squaregolab/moveoperpi/USER MANUAL/schema moveo.jpg

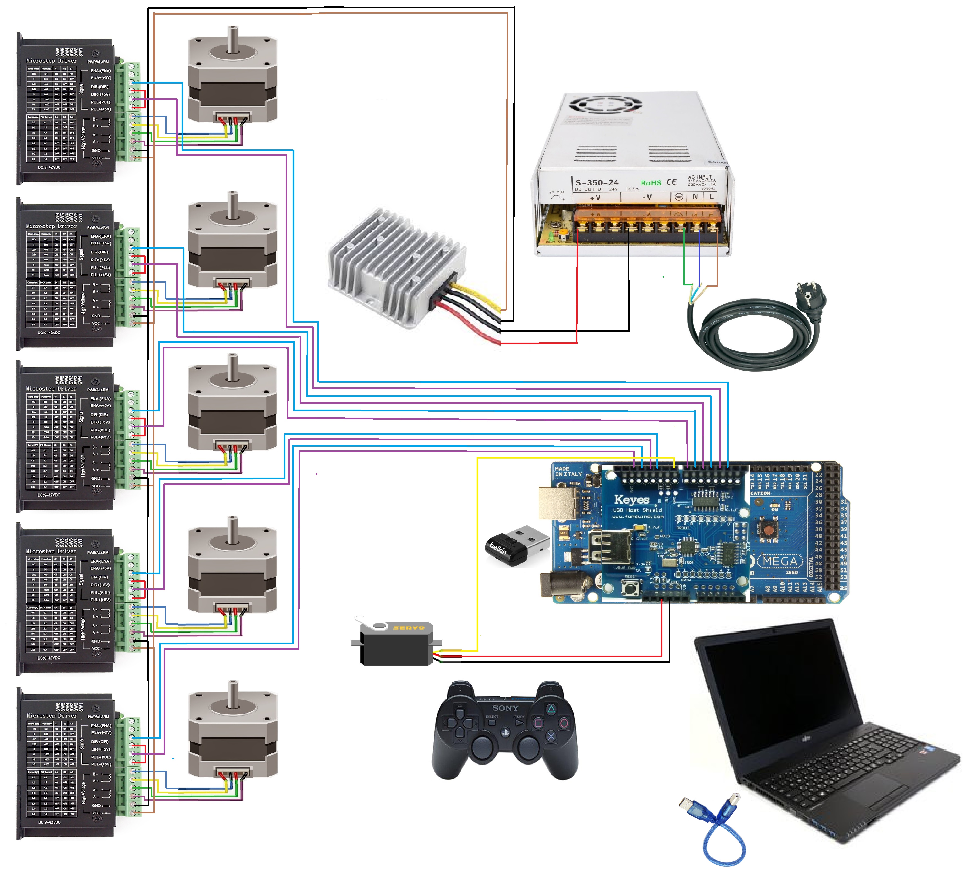
USER MANUAL/schema moveo.jpg
