squaregolab/moveoperpi/PHOTOS/20180124_114116.jpg

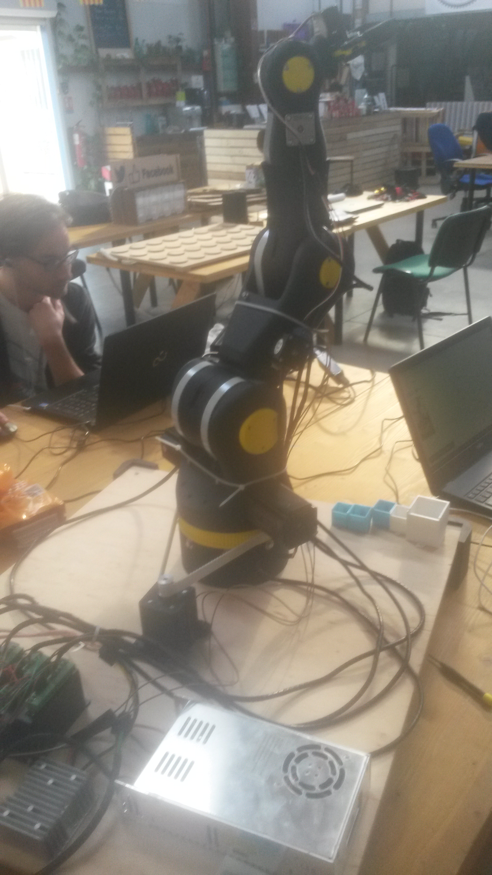
PHOTOS/20180124_114116.jpg
