squaregolab/moveoperpi/PHOTOS/20180117_152939.jpg

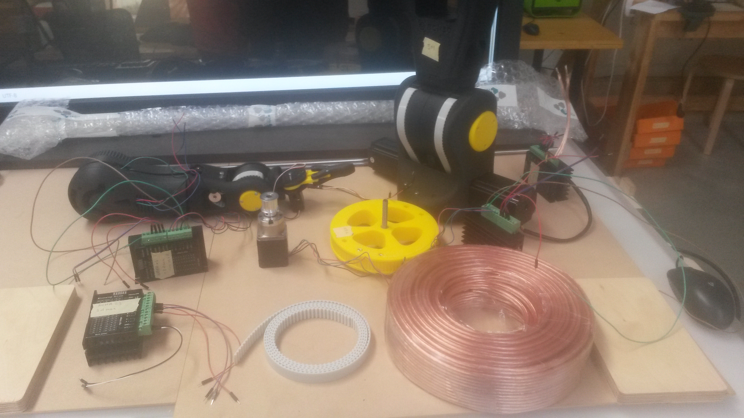
PHOTOS/20180117_152939.jpg
