squaregolab/moveoperpi/PHOTOS/20180117_152953.jpg

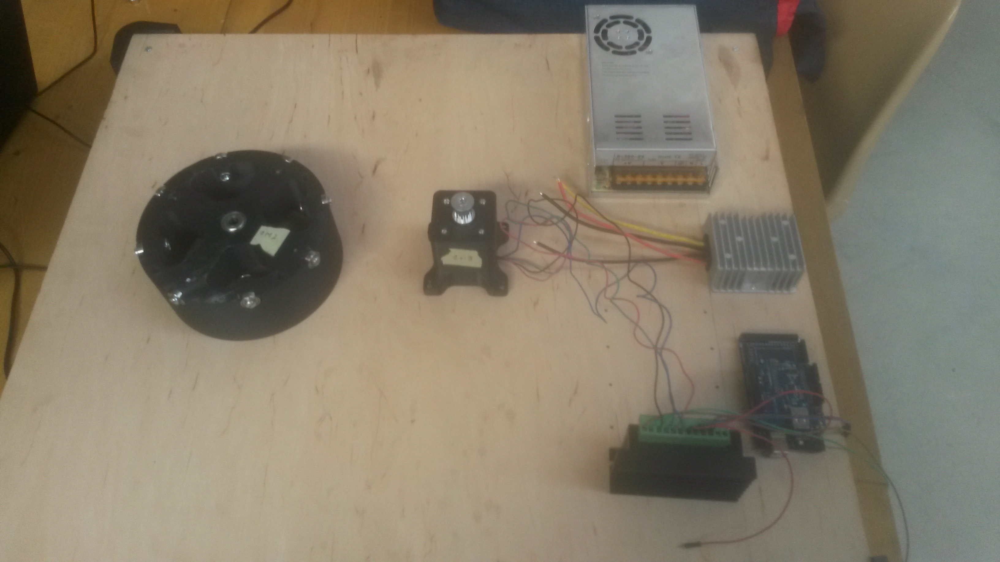
PHOTOS/20180117_152953.jpg
