squaregolab/moveoperpi/PHOTOS/20180117_153352.jpg

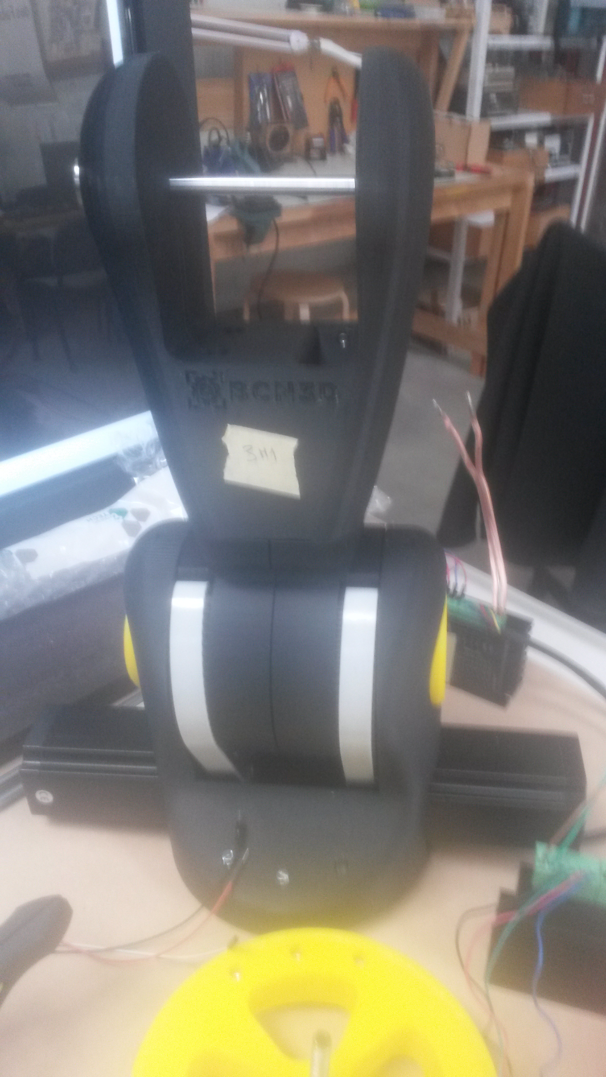
PHOTOS/20180117_153352.jpg
