squaregolab/moveoperpi/PHOTOS/20180117_153404.jpg

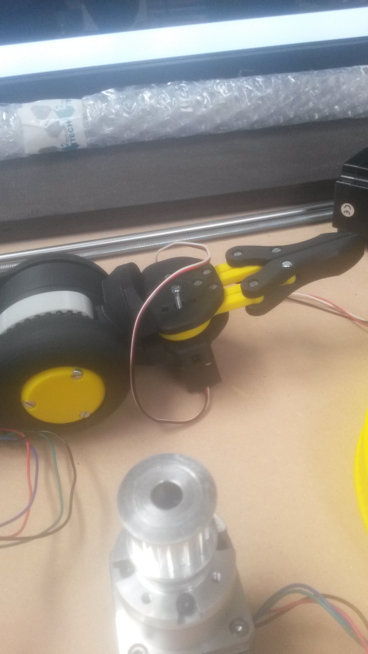
PHOTOS/20180117_153404.jpg
