squaregolab/moveoperpi/PHOTOS/20180117_153409.jpg

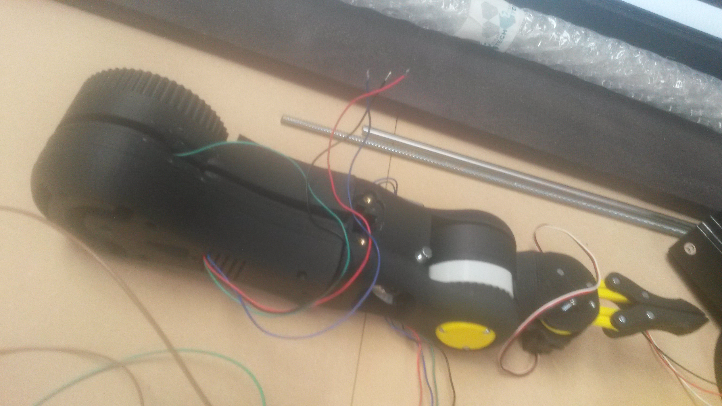
PHOTOS/20180117_153409.jpg
