squaregolab/moveoperpi/PHOTOS/20180118_113516.jpg

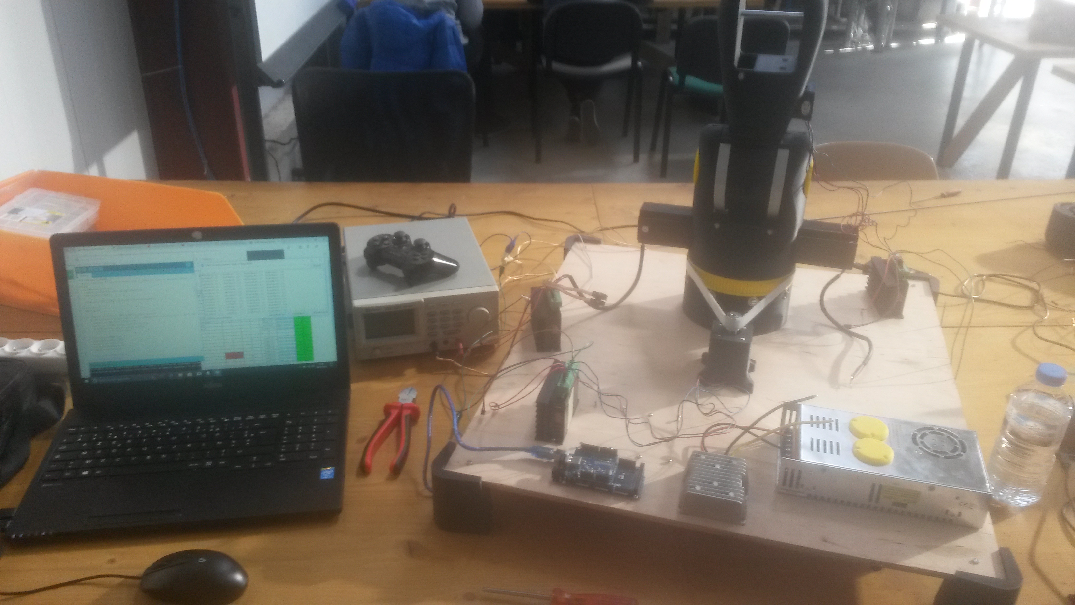
PHOTOS/20180118_113516.jpg
