squaregolab/moveoperpi/PHOTOS/20180118_113524.jpg

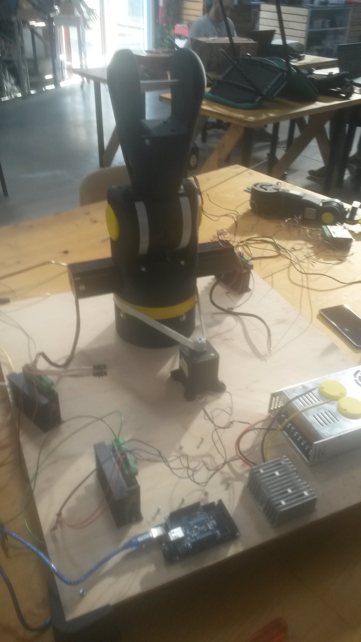
PHOTOS/20180118_113524.jpg
