squaregolab/moveoperpi/PHOTOS/20180122_131329.jpg

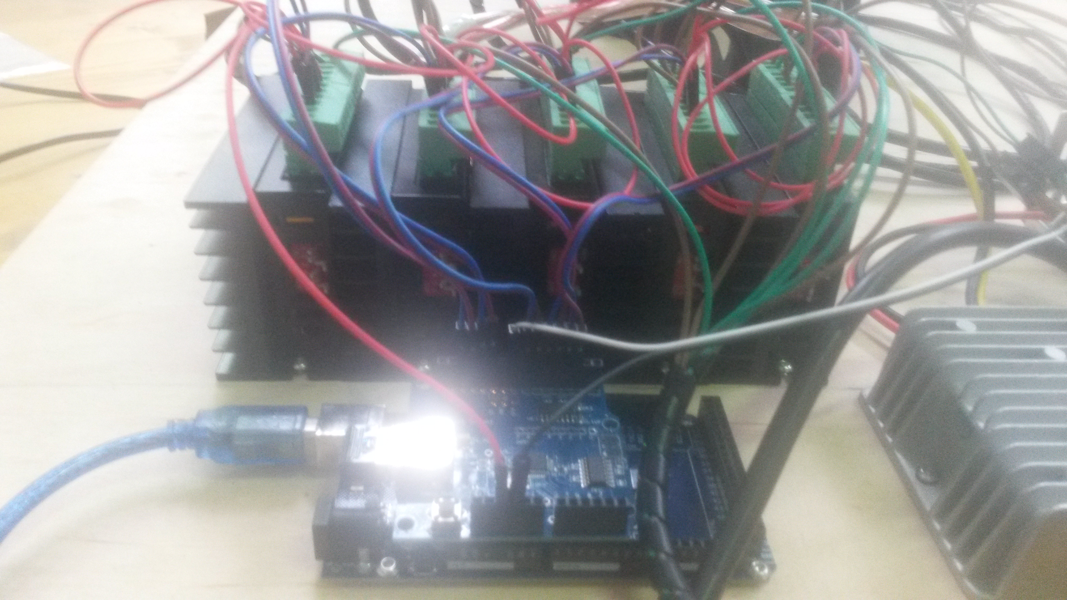
PHOTOS/20180122_131329.jpg
