squaregolab/moveoperpi/PHOTOS/20180122_131335.jpg

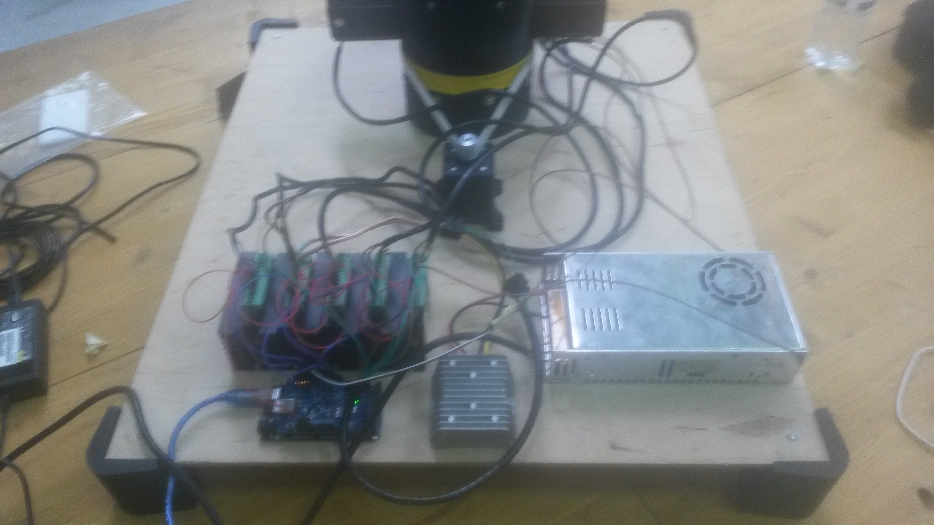
PHOTOS/20180122_131335.jpg
