squaregolab/moveoperpi/PHOTOS/20180124_090855.jpg

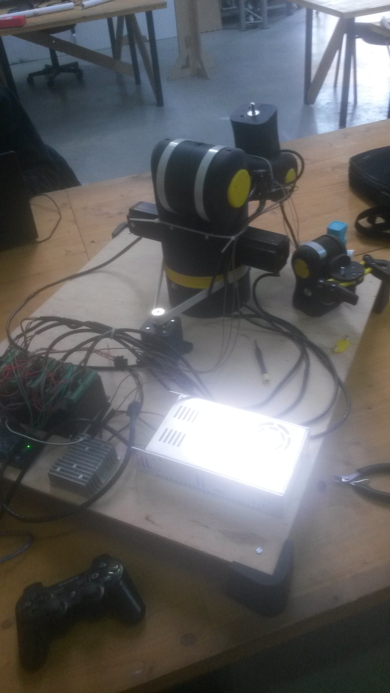
PHOTOS/20180124_090855.jpg
