squaregolab/moveoperpi/PHOTOS/20180124_114030.jpg

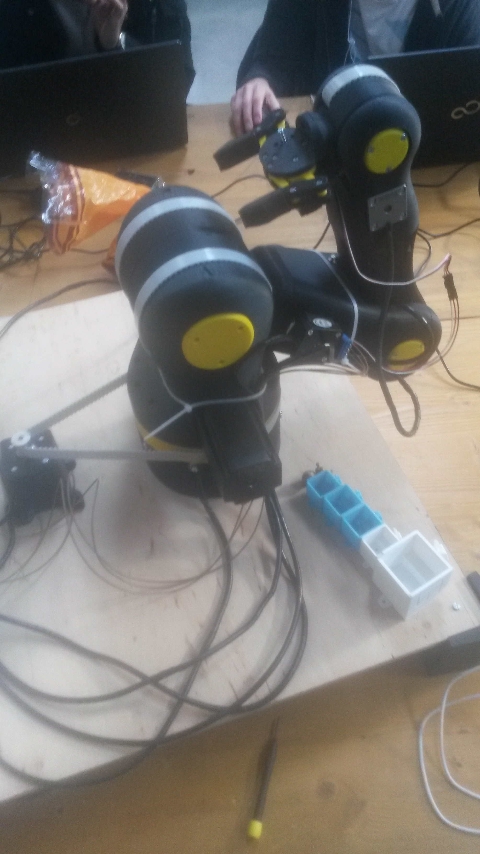
PHOTOS/20180124_114030.jpg
