squaregolab/moveoperpi/PHOTOS/20180124_114136.jpg

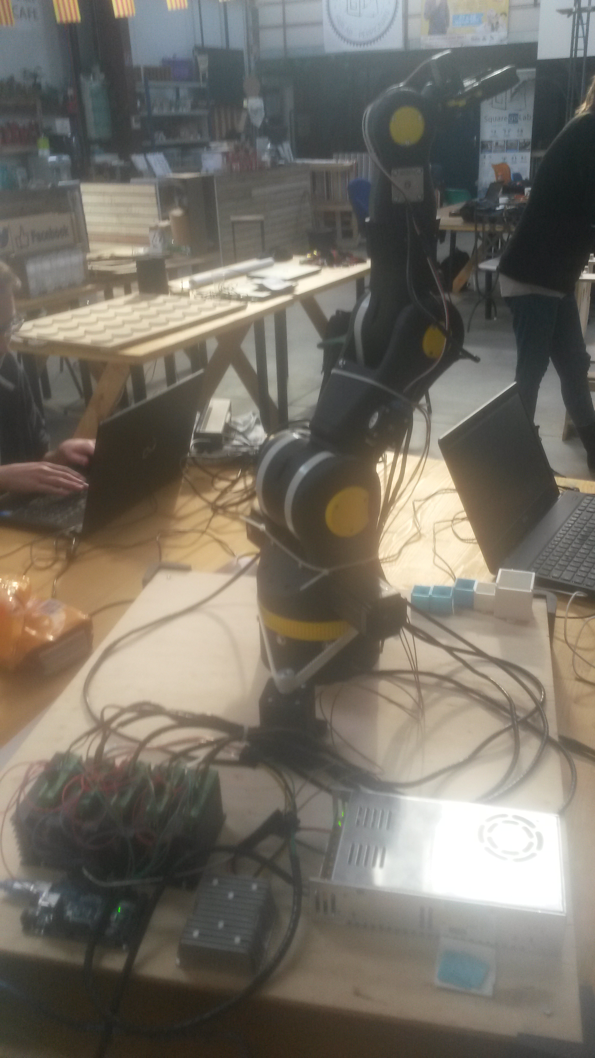
PHOTOS/20180124_114136.jpg
