squaregolab/moveoperpi/CAD files/Driver.SLDASM

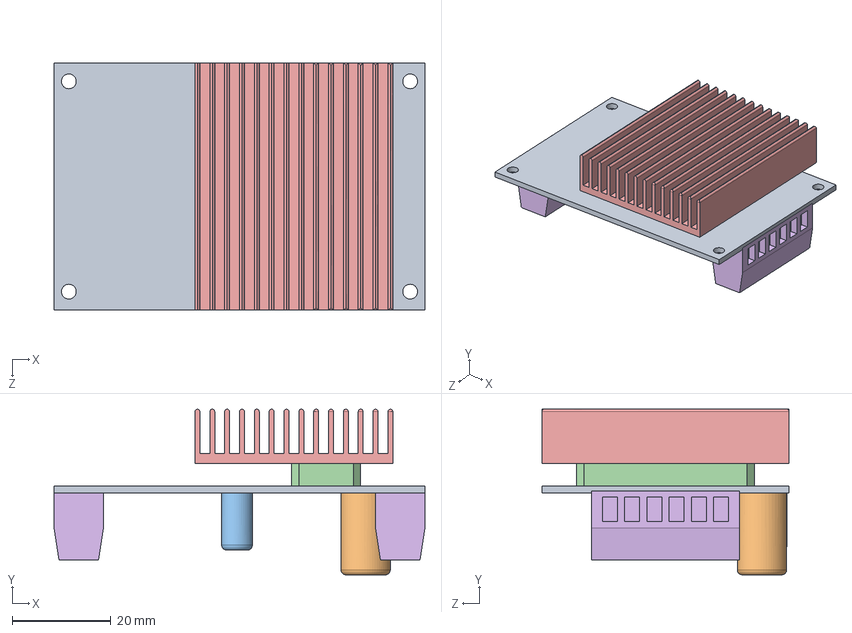
[picture p17: CAD file, 2018-02-10]
CAD files/Driver.SLDASM
75.0 x 33.5 x 50.0 mm
PCB TB6560
Capacitor 1
Capacitor 2
Chip
Sink
Terminal x 2
