squaregolab/moveoperpi/CAD files/M1 Tensor D.SLDASM

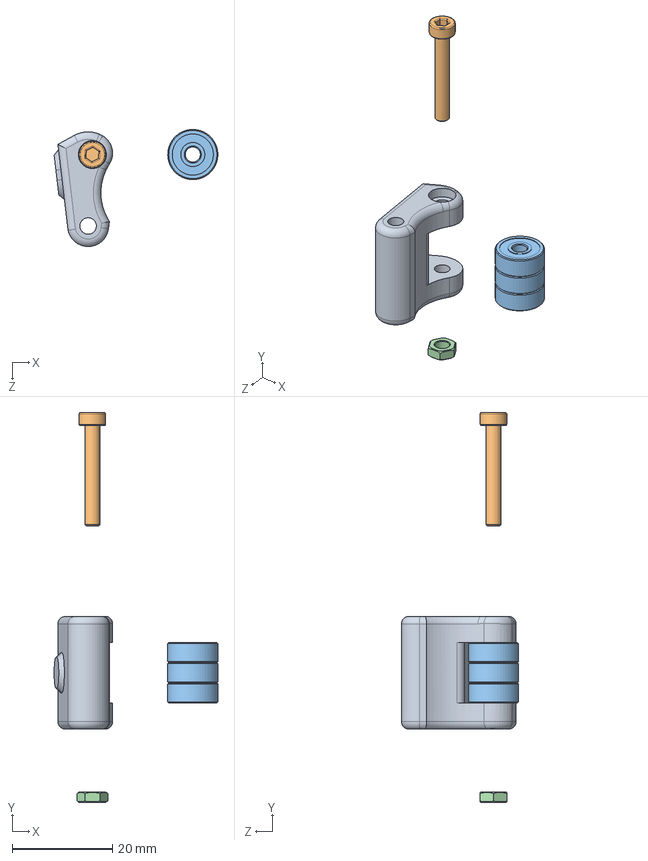
[picture p18: CAD file, 2018-02-10]
CAD files/M1 Tensor D.SLDASM
32.6 x 77.7 x 23.3 mm
T4M1E
M3x20
Bearing 3Bore 10Ext 4Height x 3
M3 Nut
