squaregolab/moveoperpi/CAD files/Rotary Plate.SLDASM

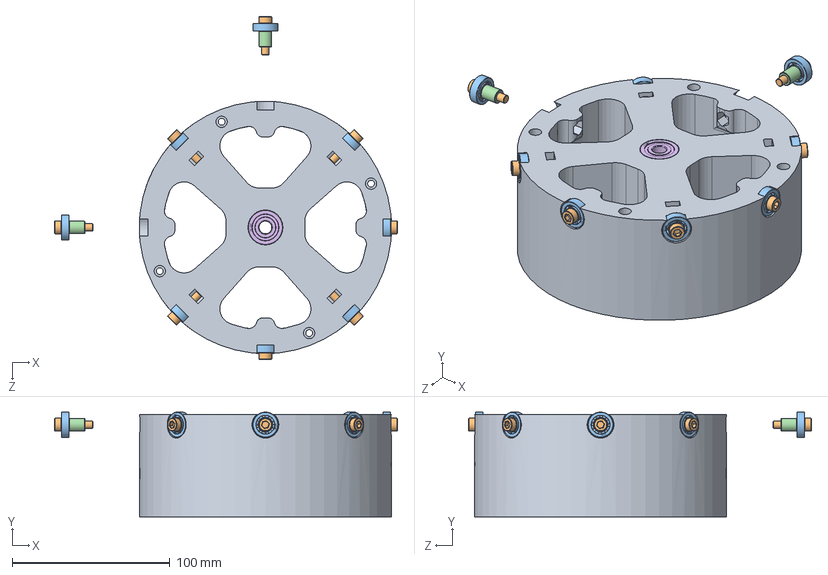
[picture p19: CAD file, 2018-02-10]
CAD files/Rotary Plate.SLDASM
217.5 x 66.5 x 217.5 mm
1M2A
M5x20 x 8
Bearing 5mm x 8
Spacer M5x10 x 8
Spacer M8x20
8mm Bearing x 2
