squaregolab/moveoperpi/CAD files/3M1.SLDASM

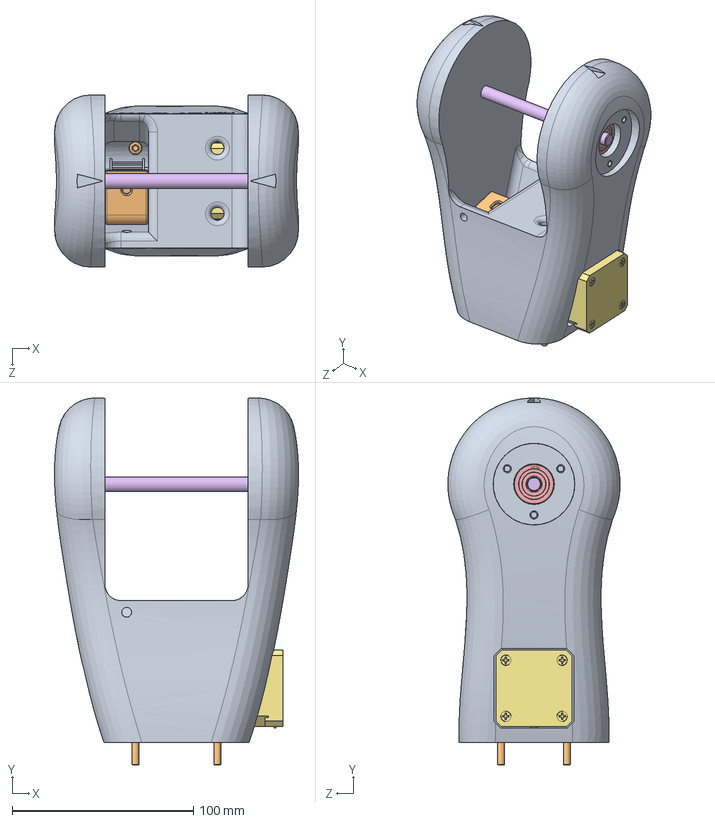
[picture p20: CAD file, 2018-02-10]
CAD files/3M1.SLDASM
134.6 x 202.4 x 95.0 mm
3M1D
T3M1C
M4 Nut
M4x20
Bearing 4Bore 13Ext 5 x 3
M3x40
Nema 17 Reductor
M3x12 x 4
Pulley 8mm IGNIS
M4x16 x 4
M3 Nut
Brass insert M3 x 6
8mm Bearing x 2
Smooth bar 8mm x 121mm
