squaregolab/moveoperpi/CAD files/Base assembly.SLDASM

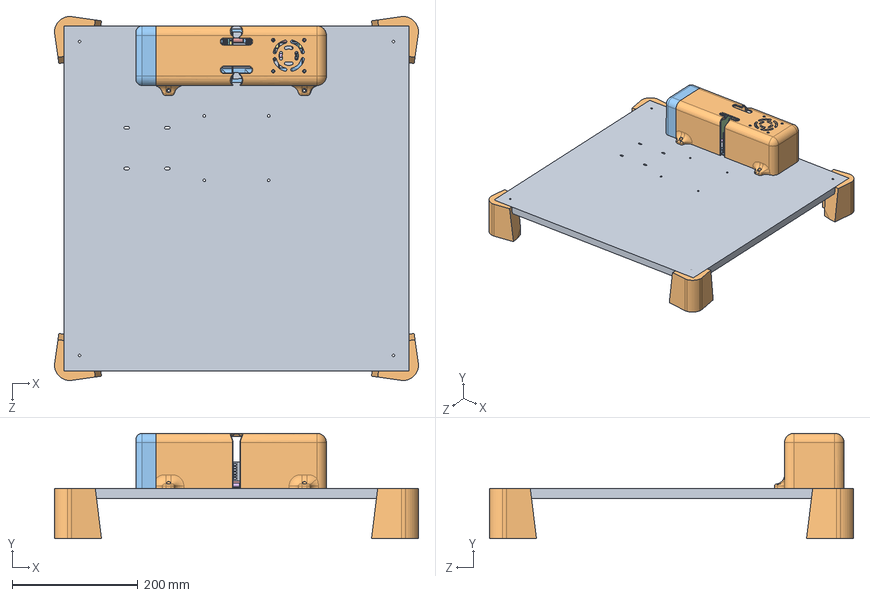
[picture p21: CAD file, 2018-02-10]
CAD files/Base assembly.SLDASM
579.8 x 168.0 x 579.8 mm
Base fusta
Potes base B x 4
Suport Drivers E
PCB TB6560 x 6
Capacitor 1 x 6
Capacitor 2 x 6
Chip x 6
Sink x 6
Terminal x 12
Box C
Fan Module
Fan
