squaregolab/moveoperpi/CAD files/Tensor I.SLDASM

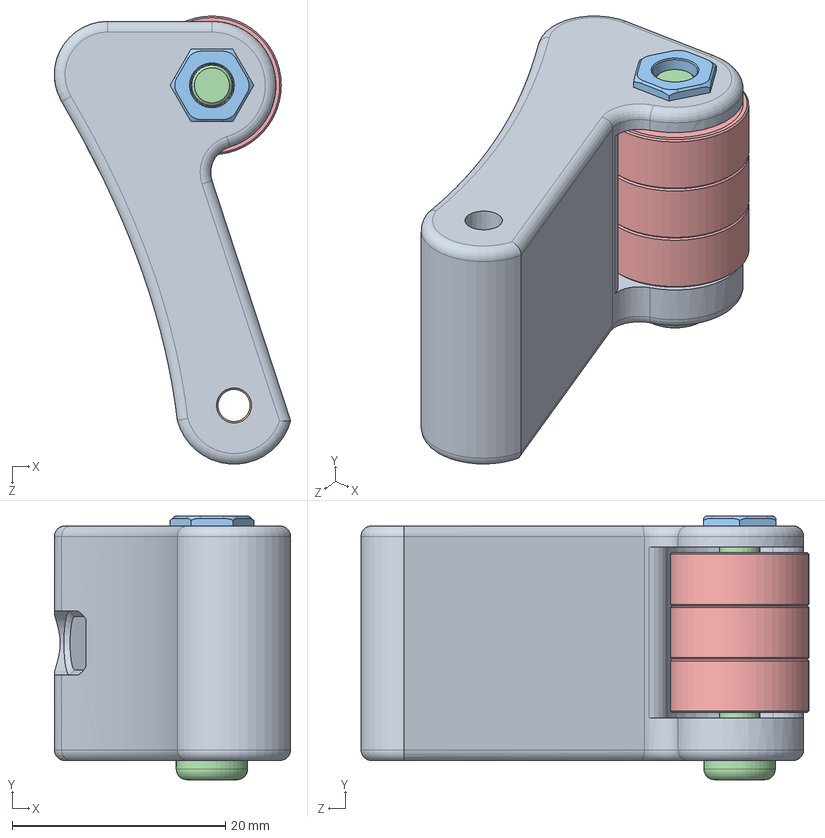
[picture p22: CAD file, 2018-02-10]
CAD files/Tensor I.SLDASM
22.2 x 24.7 x 42.0 mm
T2M1BI
M3 Nut
M4 Nut
M4x20
Bearing 4Bore 13Ext 5 x 3
