squaregolab/moveoperpi/CAD files/Sistema rodaments.SLDASM

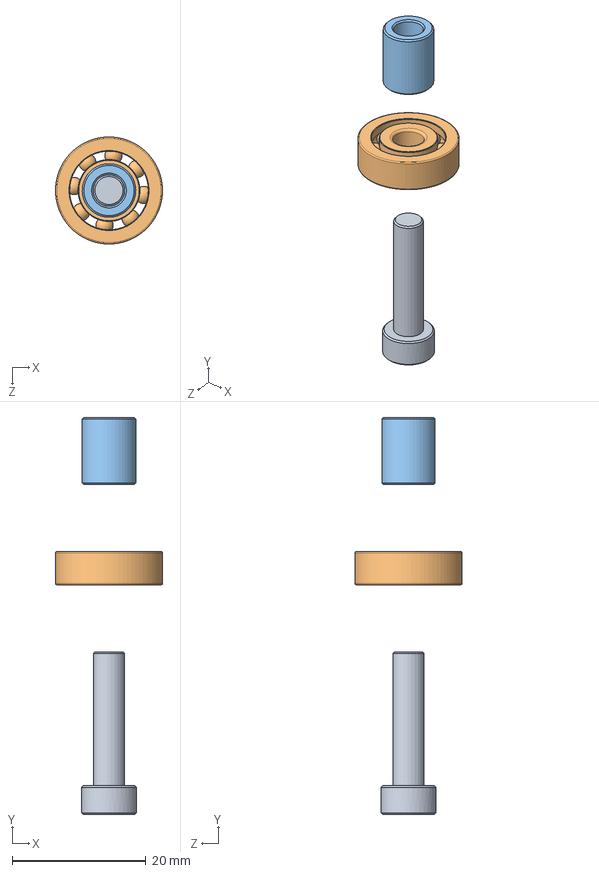
[picture p23: CAD file, 2018-02-10]
CAD files/Sistema rodaments.SLDASM
16.0 x 59.3 x 16.0 mm
M5x20
Bearing 5mm
Spacer M5x10
