squaregolab/moveoperpi/CAD files/2.SLDASM

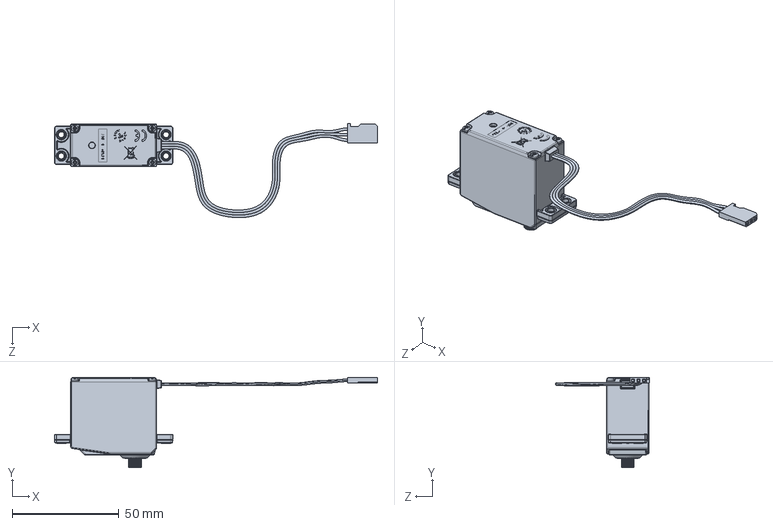
[picture p24: CAD file, 2018-02-10]
CAD files/2.SLDASM
151.2 x 42.3 x 44.1 mm
