squaregolab/moveoperpi/CAD files/Tensor D.SLDASM

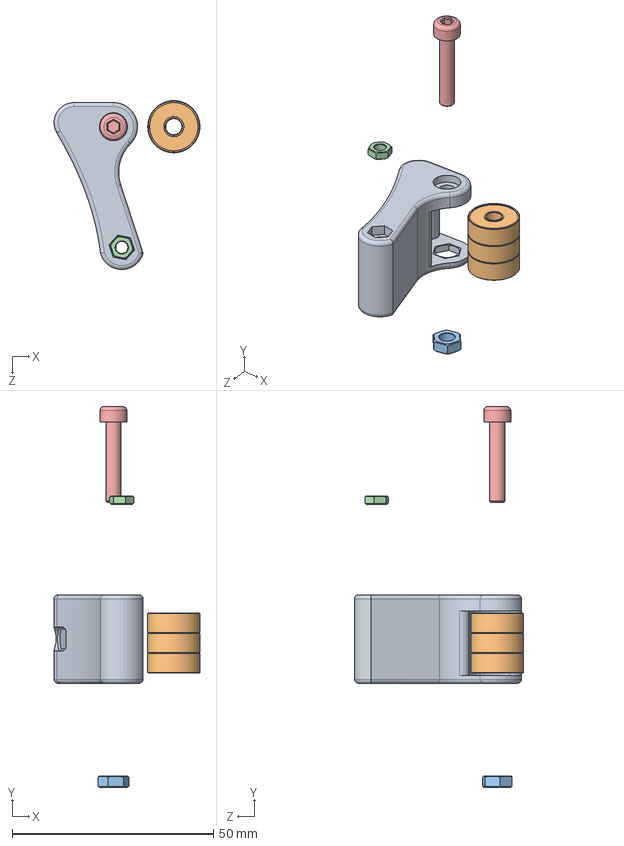
[picture p25: CAD file, 2018-02-10]
CAD files/Tensor D.SLDASM
36.3 x 94.7 x 42.0 mm
T2M1BD
Bearing 4Bore 13Ext 5 x 3
M4 Nut
M3 Nut
M4x20
Arandela
