squaregolab/moveoperpi/CAD files/2M1 assembly.SLDASM

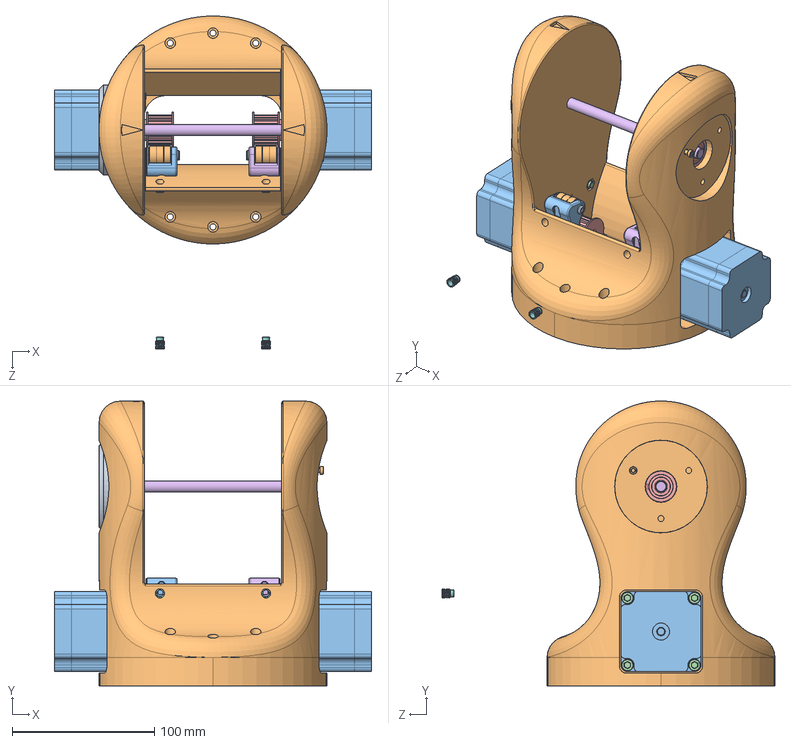
[picture p26: CAD file, 2018-02-10]
CAD files/2M1 assembly.SLDASM
222.5 x 200.0 x 233.7 mm
M5 Lock x 8
2M1D
Nema 23 x 2
M5x15 x 8
8mm Bearing x 2
T2M1BI
M3 Nut x 2
M4 Nut x 2
M4x20 x 2
Bearing 4Bore 13Ext 5 x 6
T2M1BD
Arandela
Pulley 8mm IGNIS x 2
Smooth bar 8mm x 140mm
Brass insert M4 x 2
