squaregolab/moveoperpi/CAD files/4M2.SLDASM

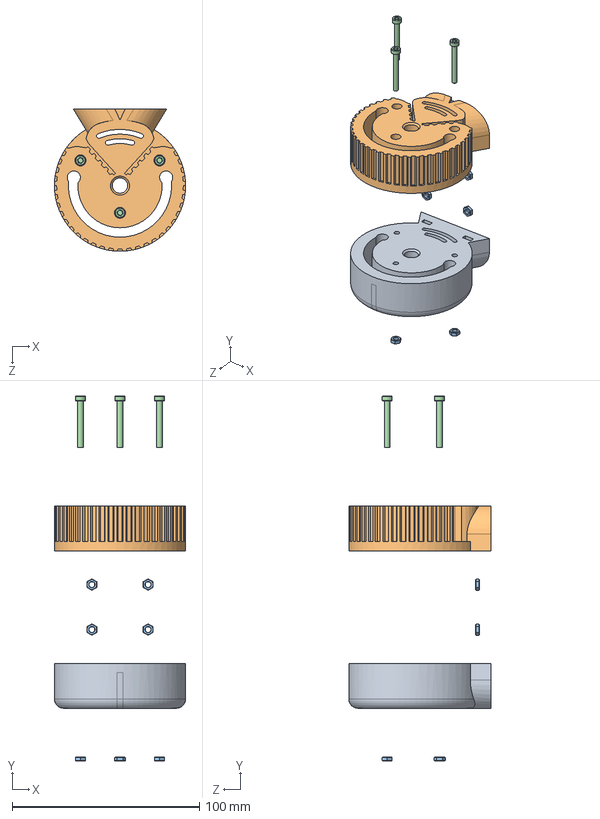
[picture p27: CAD file, 2018-02-10]
CAD files/4M2.SLDASM
70.0 x 194.7 x 76.0 mm
4M2B
4M2CB
M3 Nut x 7
M3x25 x 3
