squaregolab/moveoperpi/CAD files/Module Fan Assembly.SLDASM

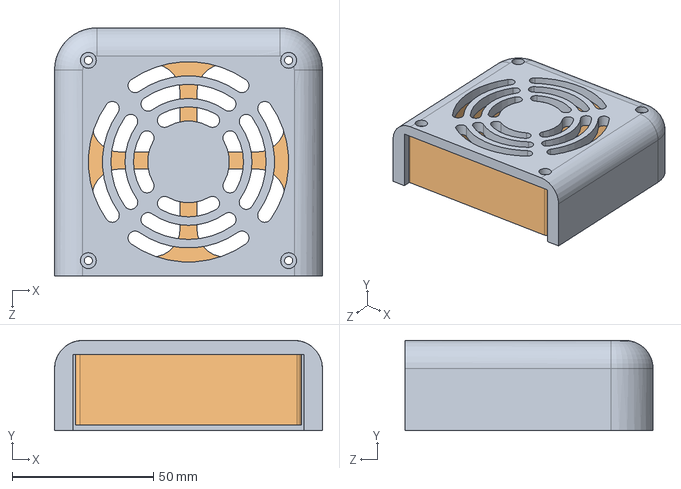
[picture p28: CAD file, 2018-02-10]
CAD files/Module Fan Assembly.SLDASM
95.0 x 32.0 x 88.0 mm
Fan Module
Fan
