squaregolab/moveoperpi/CAD files/Box Assembly B.SLDASM

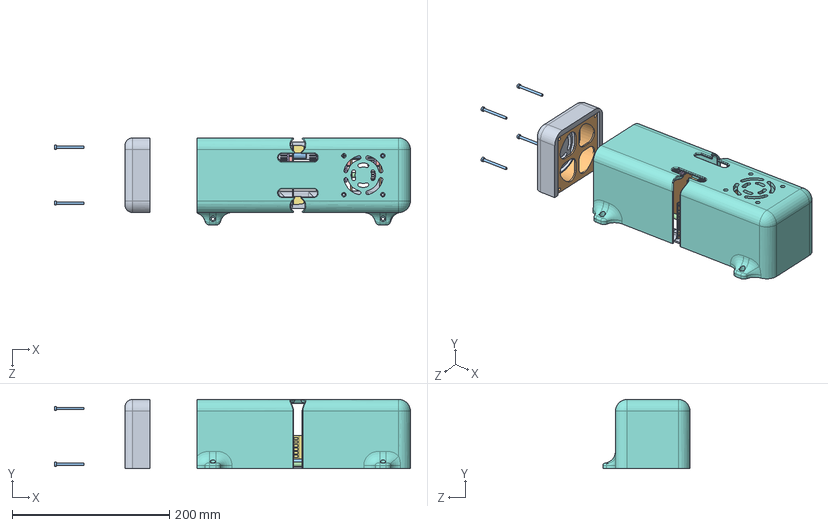
[picture p29: CAD file, 2018-02-10]
CAD files/Box Assembly B.SLDASM
453.0 x 88.0 x 111.0 mm
Suport Drivers E
PCB TB6560 x 6
Capacitor 1 x 6
Capacitor 2 x 6
Chip x 6
Sink x 6
Terminal x 12
Box C
Fan Module
Fan
M3x35 x 4
