squaregolab/moveoperpi/CAD files/T3M1.SLDASM

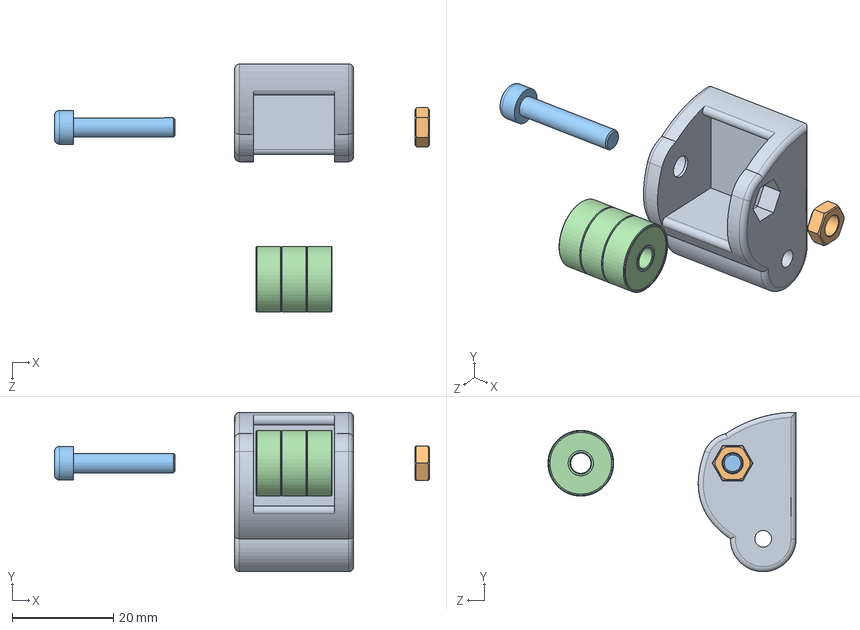
[picture p30: CAD file, 2018-02-10]
CAD files/T3M1.SLDASM
74.1 x 31.5 x 49.0 mm
T3M1C
M4 Nut
M4x20
Bearing 4Bore 13Ext 5 x 3
