squaregolab/moveoperpi/CAD files/2M2.SLDASM

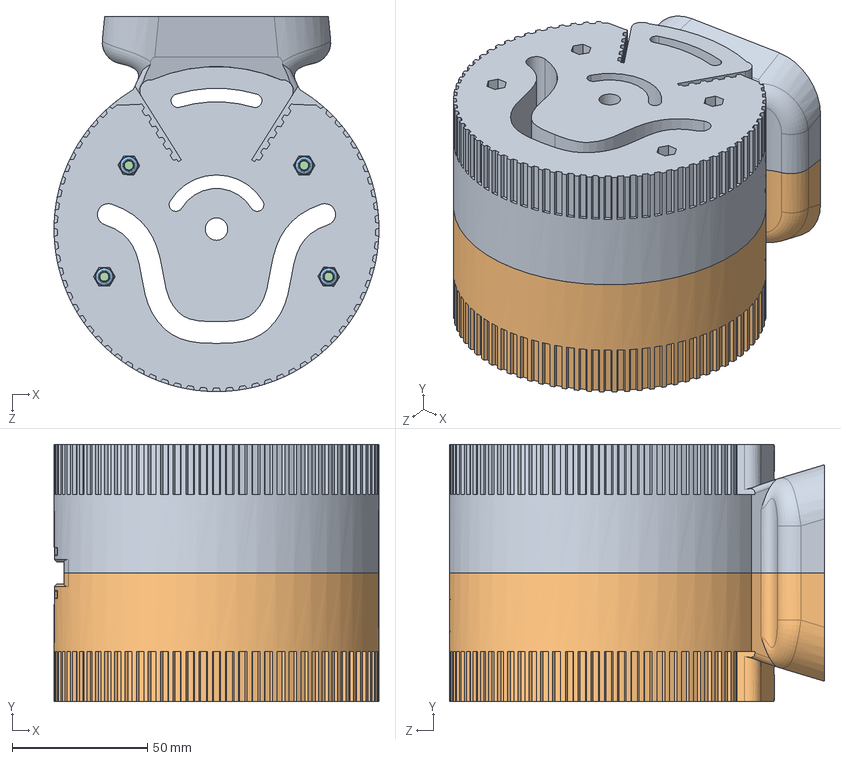
[picture p32: CAD file, 2018-02-10]
CAD files/2M2.SLDASM
120.0 x 95.0 x 138.5 mm
2M2HA
2M2MA
M4 Locknut x 4
M4x30 x 4
M4 Nut x 4
