squaregolab/moveoperpi/CAD files/1M3.SLDASM

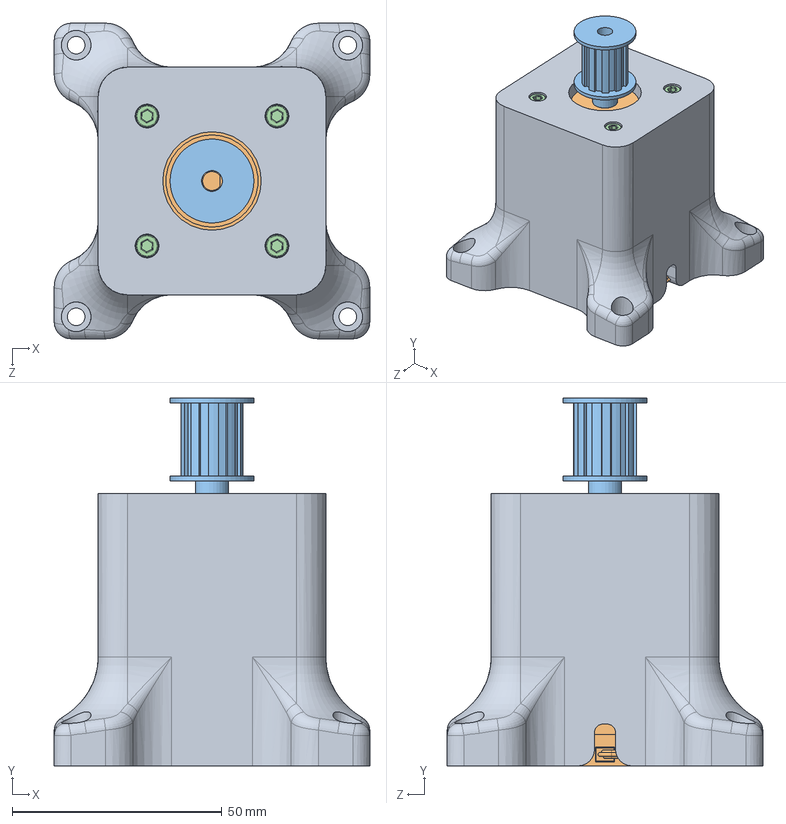
[picture p34: CAD file, 2018-02-10]
CAD files/1M3.SLDASM
75.3 x 87.8 x 75.3 mm
1M3A
Nema 17 Llarg
Pulley M5
M3x10 x 4
