squaregolab/moveoperpi/CAD files/2M2M assembly.SLDASM

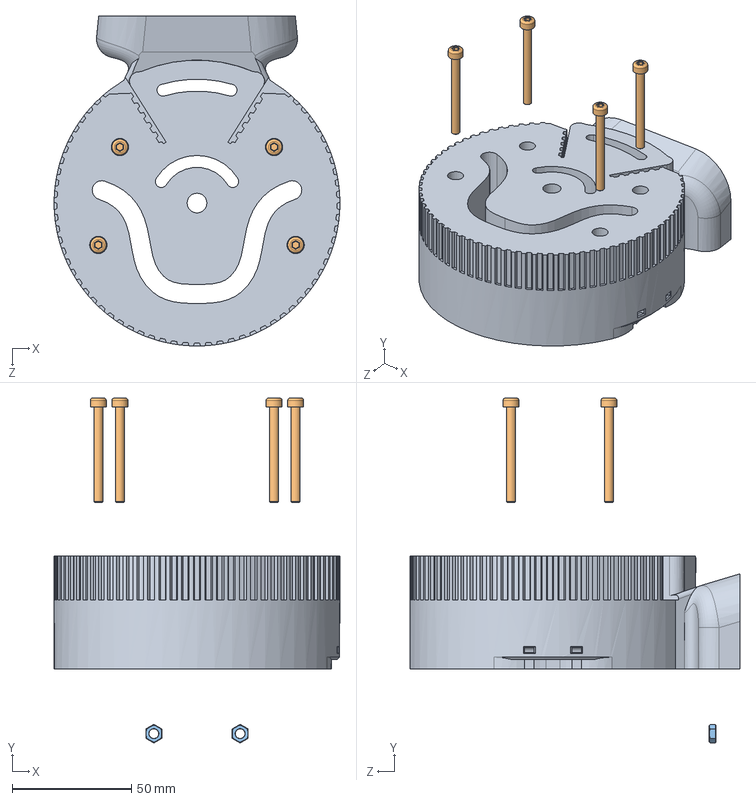
[picture p35: CAD file, 2018-02-10]
CAD files/2M2M assembly.SLDASM
120.0 x 144.8 x 138.5 mm
2M2MA
M4x40 x 4
M4 Nut x 2
