squaregolab/moveoperpi/CAD files/Smooth bar 8mm x 121mm.SLDPRT

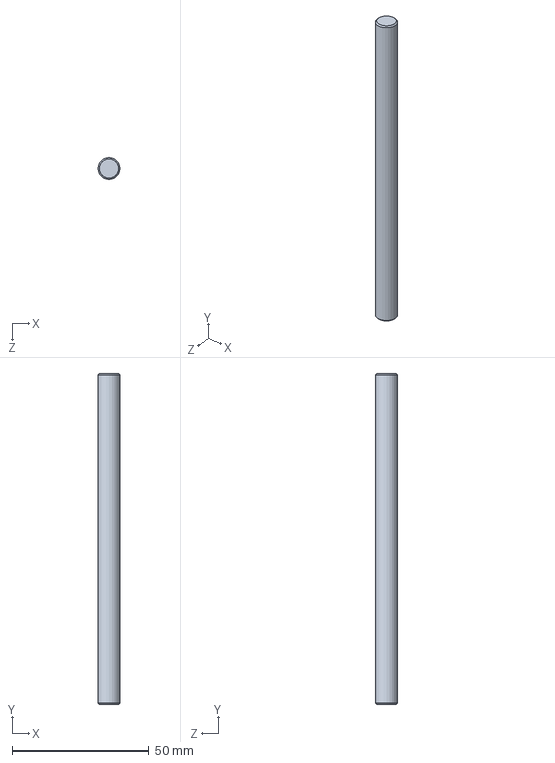
[picture p36: CAD file, 2018-02-10]
CAD files/Smooth bar 8mm x 121mm.SLDPRT
8.00 x 121.0 x 8.00 mm
