squaregolab/moveoperpi/STL files/Articulation 1/1M1.STL

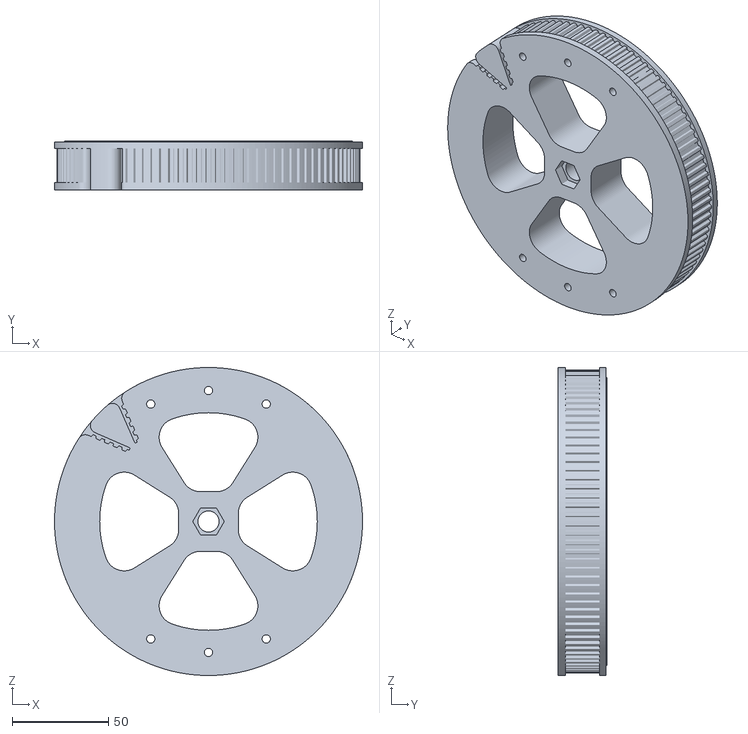
[picture p37: CAD file, 2018-02-10]
STL files/Articulation 1/1M1.STL
160.0 x 25.5 x 160.0
