squaregolab/moveoperpi/STL files/Articulation 2/2M2M.STL

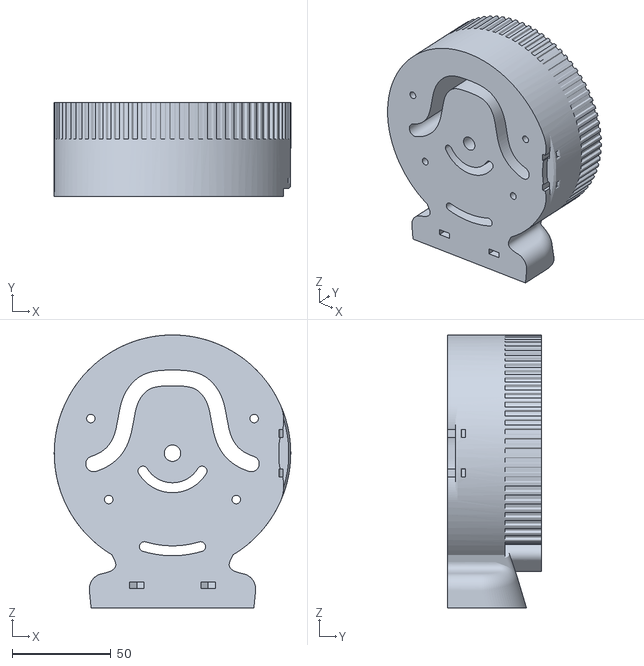
[picture p38: CAD file, 2018-02-10]
STL files/Articulation 2/2M2M.STL
120.0 x 47.5 x 138.5
