squaregolab/moveoperpi/STL files/Articulation 3/T3M1C.stl

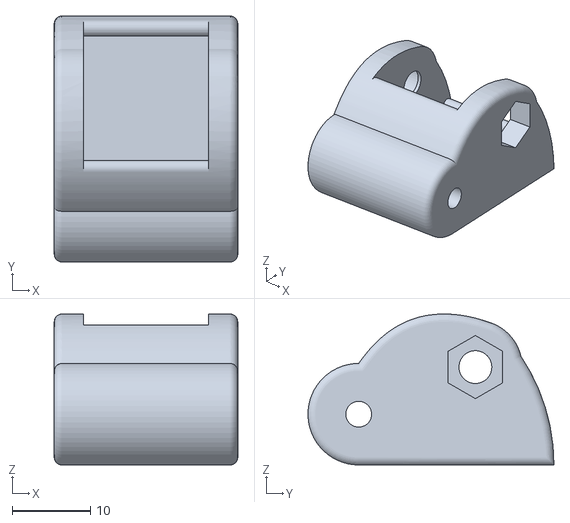
[picture p39: CAD file, 2018-02-10]
STL files/Articulation 3/T3M1C.stl
23.5 x 31.5 x 19.3
