squaregolab/moveoperpi/STL files/Articulation 4/4M2C.STL

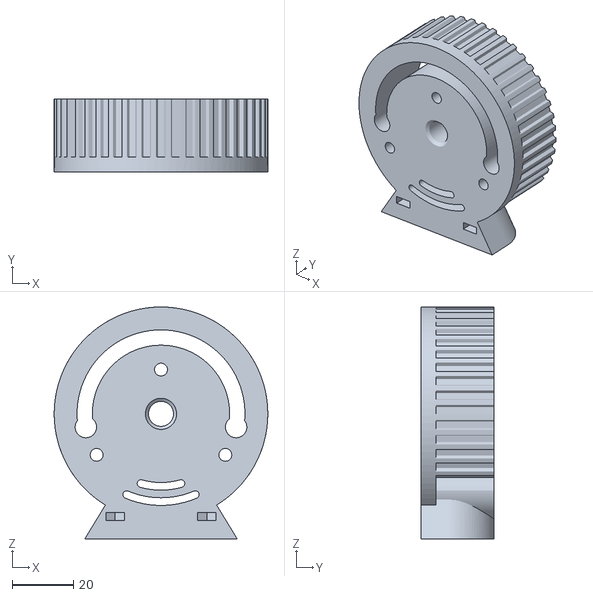
[picture p40: CAD file, 2018-02-10]
STL files/Articulation 4/4M2C.STL
70.0 x 24.0 x 76.0
