squaregolab/moveoperpi/STL files/Base/Potes.STL

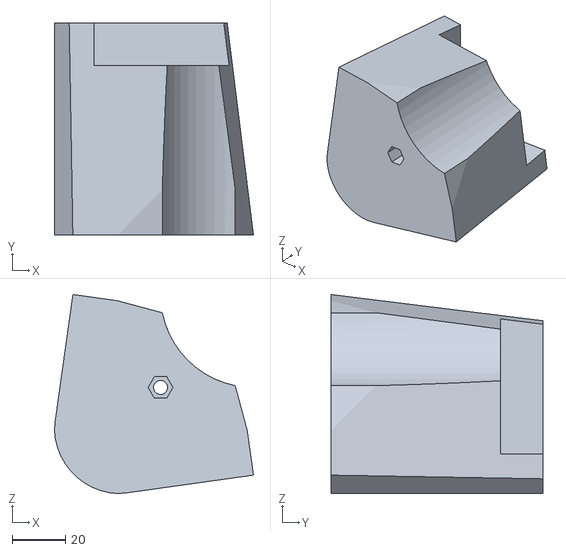
[picture p41: CAD file, 2018-02-10]
STL files/Base/Potes.STL
74.9 x 80.0 x 74.9
