squaregolab/moveoperpi/STL files/Cover/Tapa 3M1.STL

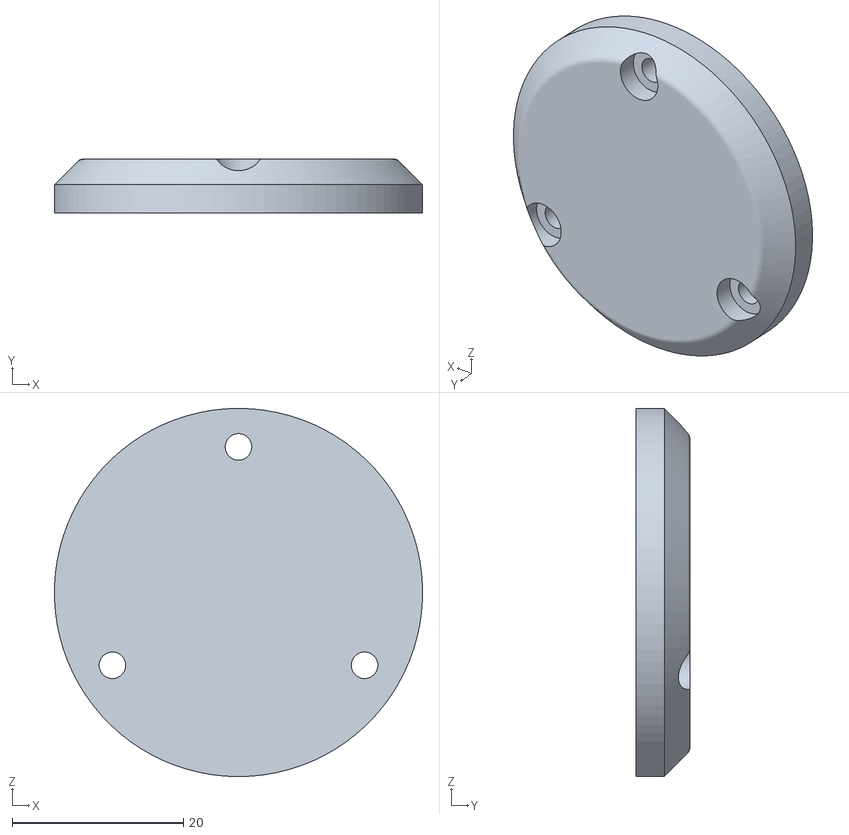
[picture p42: CAD file, 2018-02-10]
STL files/Cover/Tapa 3M1.STL
43.0 x 6.30 x 43.0
