squaregolab/moveoperpi/STL files/Electronics box/Fan Module.STL

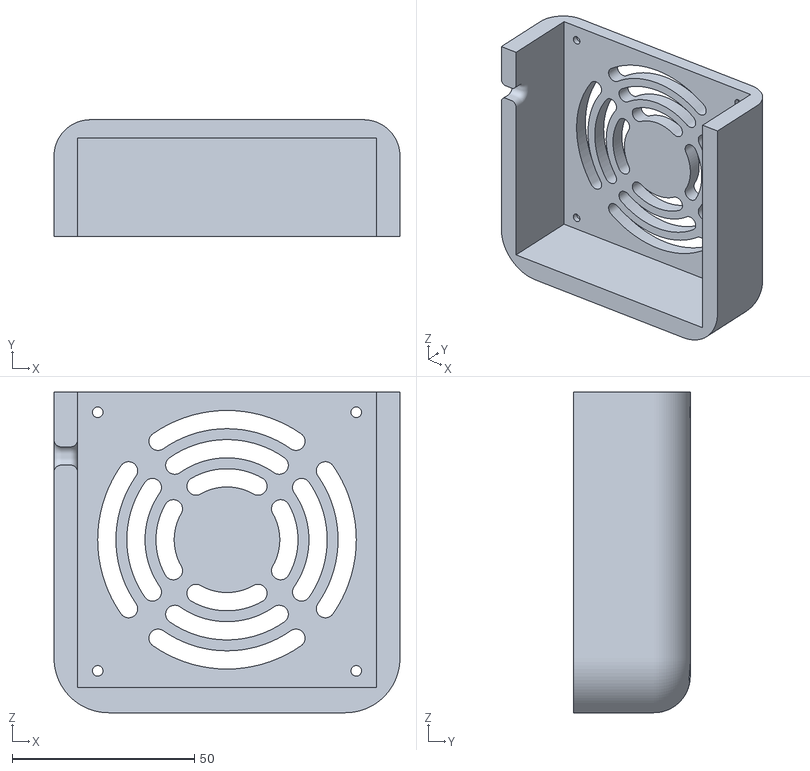
[picture p43: CAD file, 2018-02-10]
STL files/Electronics box/Fan Module.STL
95.0 x 32.0 x 88.0
