squaregolab/moveoperpi/STL files/Machine - tool/Top Plate.STL

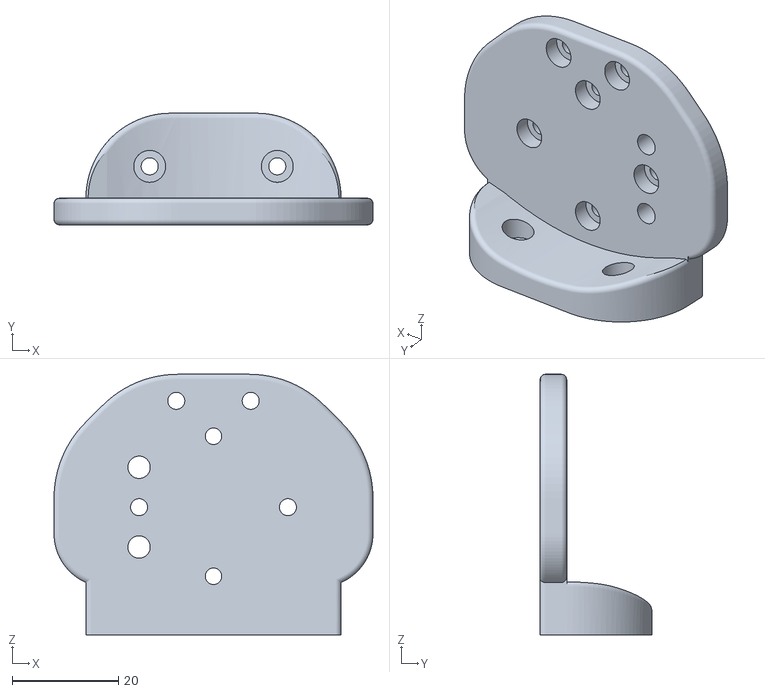
[picture p44: CAD file, 2018-02-10]
STL files/Machine - tool/Top Plate.STL
60.0 x 21.0 x 49.0
