squaregolab/moveoperpi/CAD files/1M2A.SLDPRT

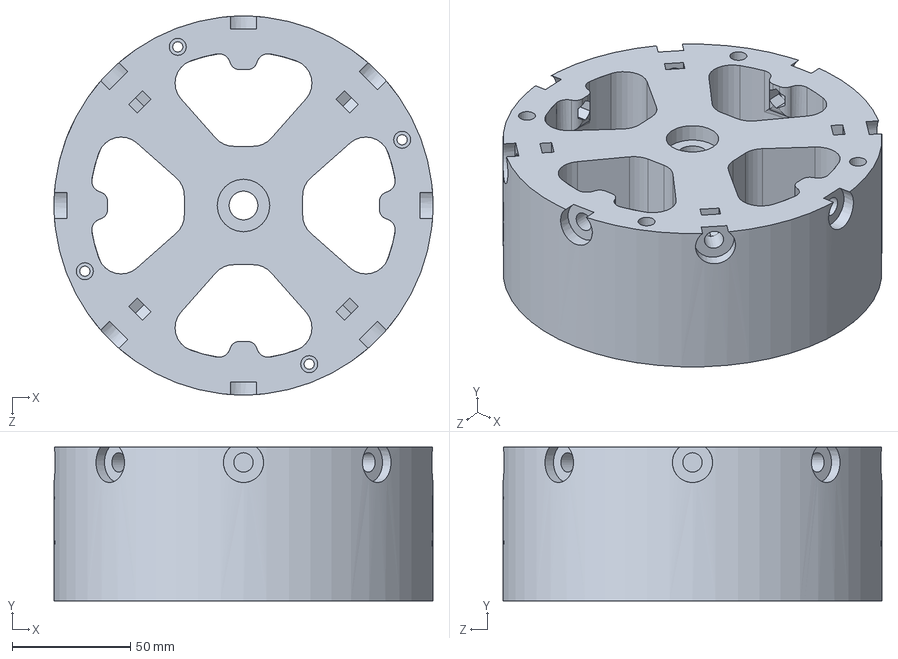
[picture p45: CAD file, 2018-02-10]
CAD files/1M2A.SLDPRT
160.0 x 65.0 x 160.0 mm
