squaregolab/moveoperpi/STL files/Articulation 3/3M2C.STL

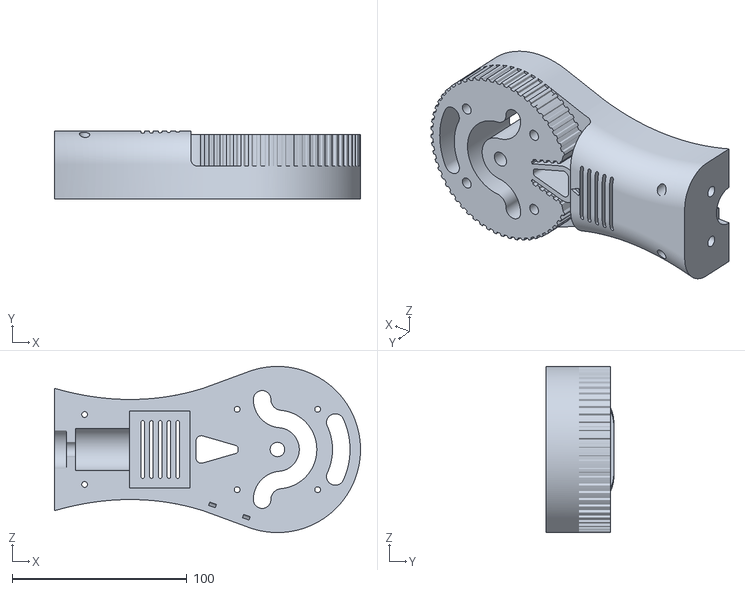
[picture p46: CAD file, 2018-02-10]
STL files/Articulation 3/3M2C.STL
175.0 x 38.8 x 95.0
