squaregolab/moveoperpi/STL files/Articulation 4/T4M1E.stl

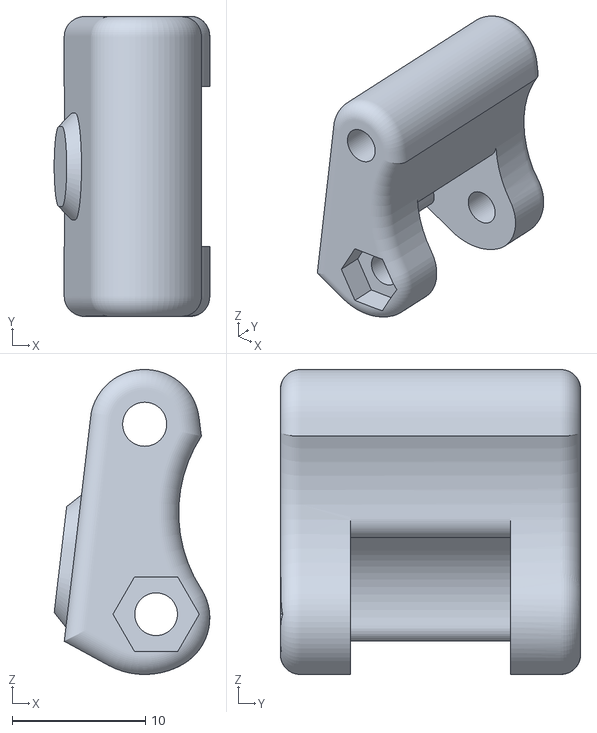
[picture p47: CAD file, 2018-02-10]
STL files/Articulation 4/T4M1E.stl
11.7 x 22.5 x 22.9
