squaregolab/moveoperpi/STL files/Cover/Tapa 2M1.STL

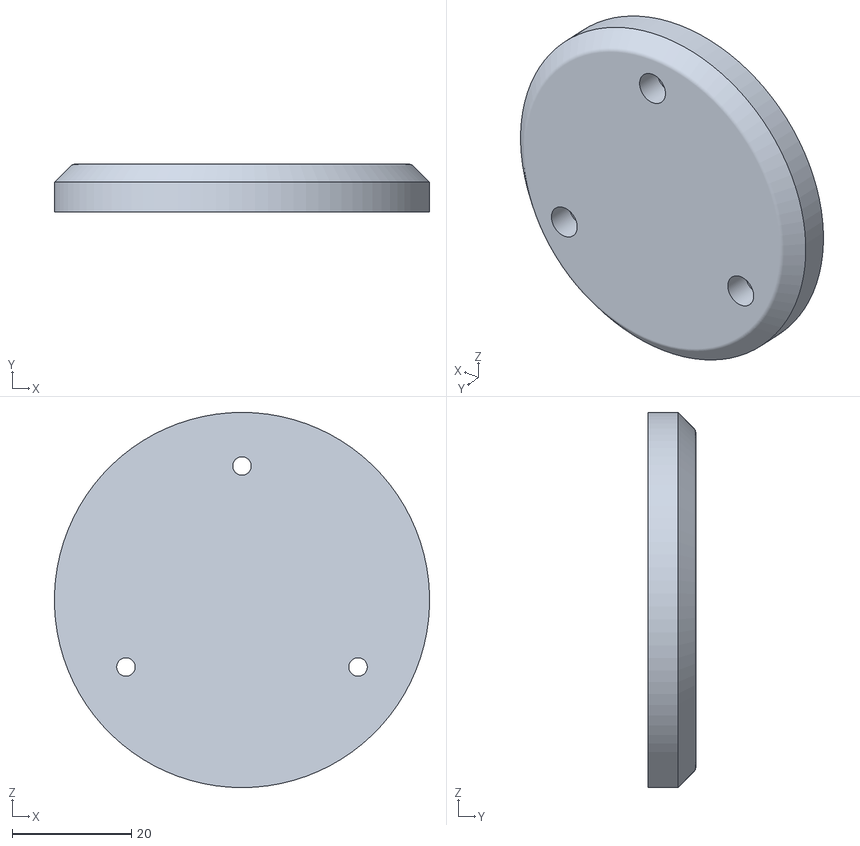
[picture p48: CAD file, 2018-02-10]
STL files/Cover/Tapa 2M1.STL
63.0 x 8.00 x 63.0
