squaregolab/moveoperpi/STL files/Electronics box/Suport Drivers.STL

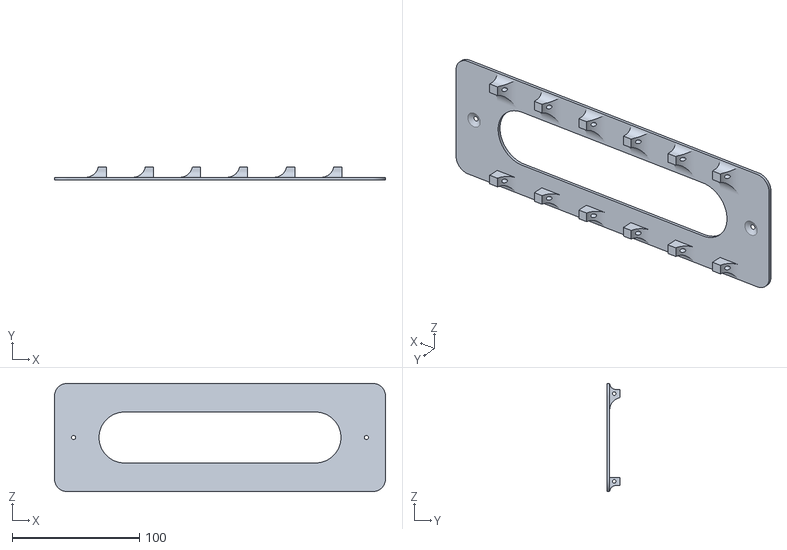
[picture p49: CAD file, 2018-02-10]
STL files/Electronics box/Suport Drivers.STL
260.0 x 10.0 x 85.0
