squaregolab/moveoperpi/STL files/Machine - tool/Gripper Left.STL

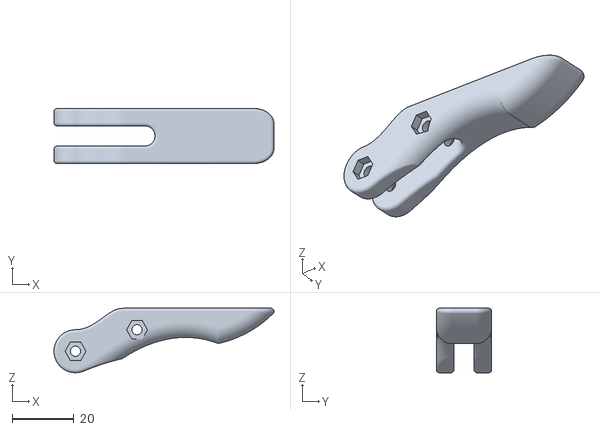
[picture p50: CAD file, 2018-02-10]
STL files/Machine - tool/Gripper Left.STL
71.5 x 18.0 x 21.0
