squaregolab/moveoperpi/CAD files/Bearing 5mm.SLDPRT

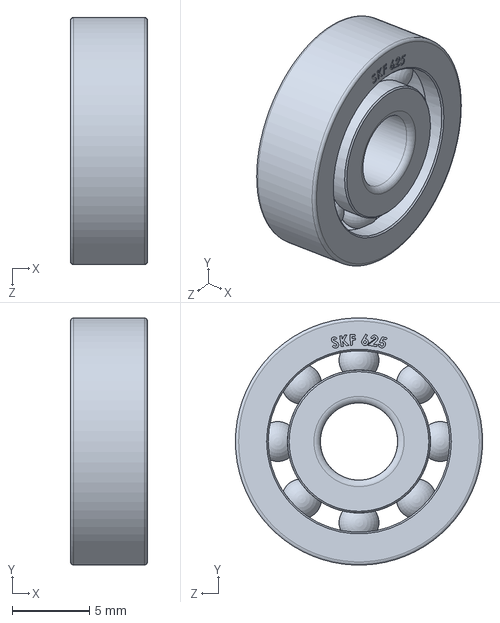
[picture p51: CAD file, 2018-02-10]
CAD files/Bearing 5mm.SLDPRT
5.00 x 16.0 x 16.0 mm
