squaregolab/moveoperpi/STL files/Articulation 2/T2M1BI.stl

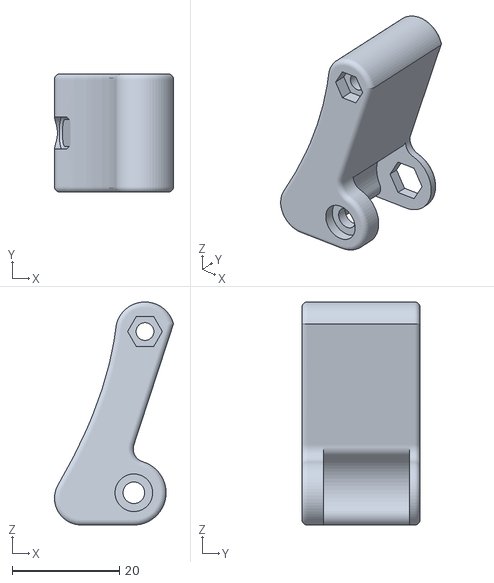
[picture p52: CAD file, 2018-02-10]
STL files/Articulation 2/T2M1BI.stl
22.2 x 22.0 x 41.5
