squaregolab/moveoperpi/STL files/Articulation 3/3M2.STL

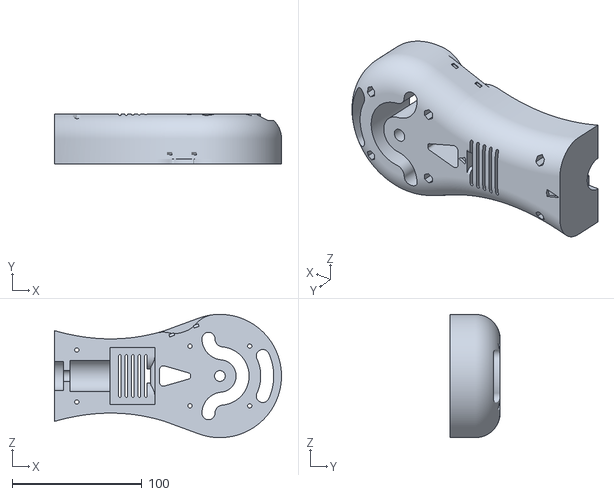
[picture p53: CAD file, 2018-02-10]
STL files/Articulation 3/3M2.STL
175.0 x 38.8 x 95.0
