squaregolab/moveoperpi/STL files/Cover/Tapa TBB.STL

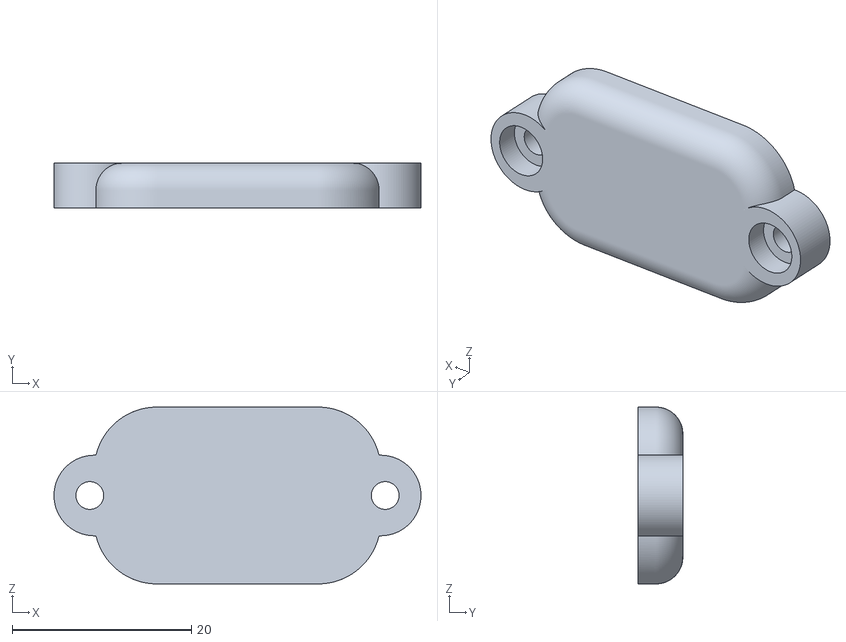
[picture p55: CAD file, 2018-02-10]
STL files/Cover/Tapa TBB.STL
41.0 x 5.00 x 19.8
