squaregolab/moveoperpi/CAD files/Arandela.SLDPRT

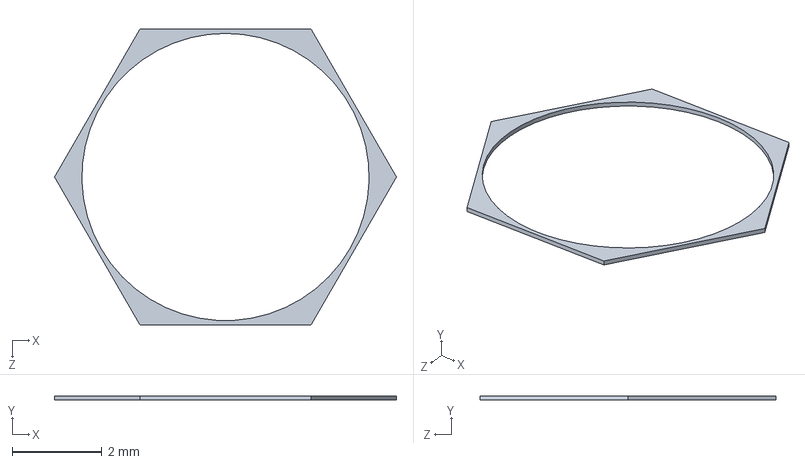
[picture p56: CAD file, 2018-02-10]
CAD files/Arandela.SLDPRT
7.62 x 0.1 x 6.60 mm
