squaregolab/moveoperpi/STL files/Articulation 3/3M1.STL

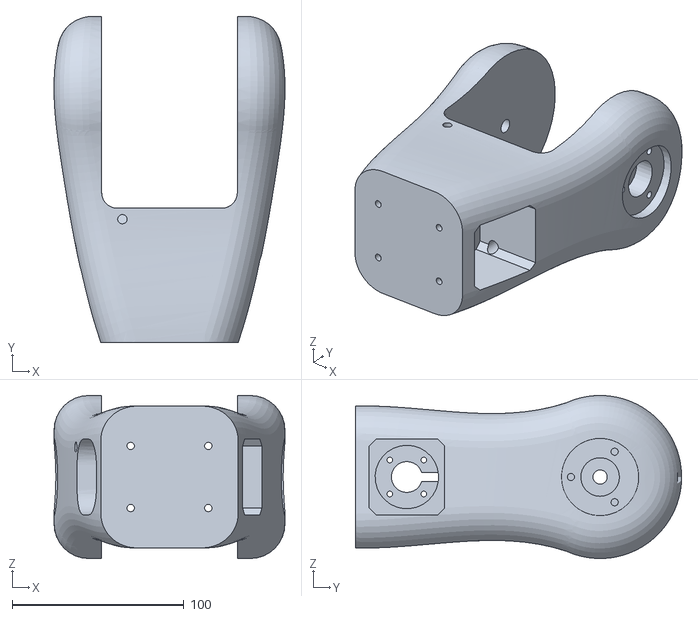
[picture p58: CAD file, 2018-02-10]
STL files/Articulation 3/3M1.STL
134.6 x 190.1 x 95.0
