squaregolab/moveoperpi/STL files/Cover/Tapa 4M1.STL

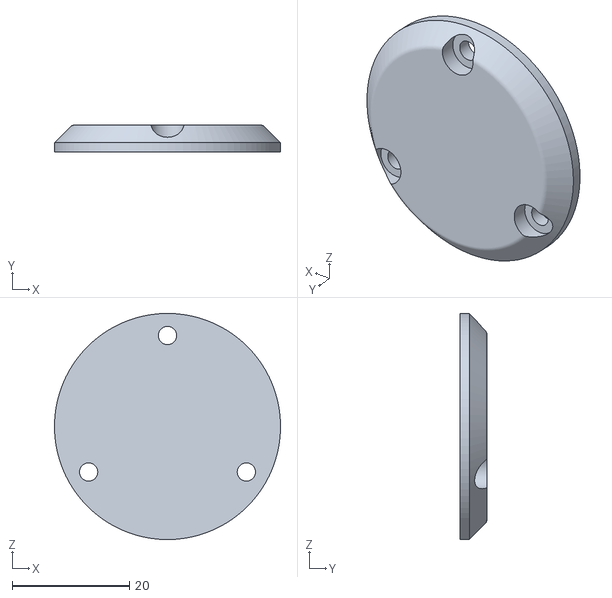
[picture p59: CAD file, 2018-02-10]
STL files/Cover/Tapa 4M1.STL
38.5 x 4.60 x 38.5
