squaregolab/moveoperpi/STL files/Machine - tool/Bottom Plate.STL

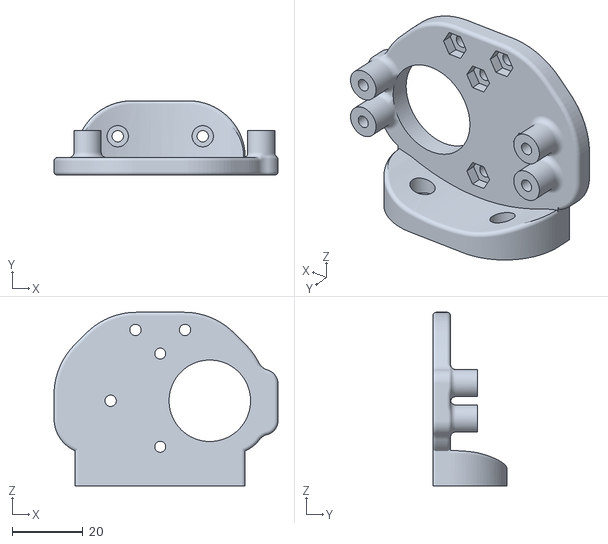
[picture p60: CAD file, 2018-02-10]
STL files/Machine - tool/Bottom Plate.STL
63.2 x 21.0 x 49.0
