squaregolab/moveoperpi/STL files/Machine - tool/Pivot Arm.STL

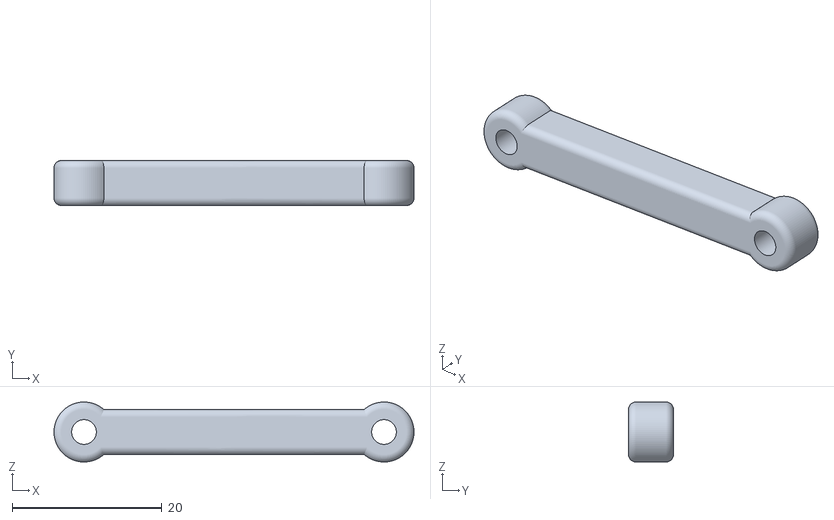
[picture p61: CAD file, 2018-02-10]
STL files/Machine - tool/Pivot Arm.STL
48.0 x 6.00 x 8.00
