squaregolab/moveoperpi/STL files/Machine - tool/Servo Gear.STL

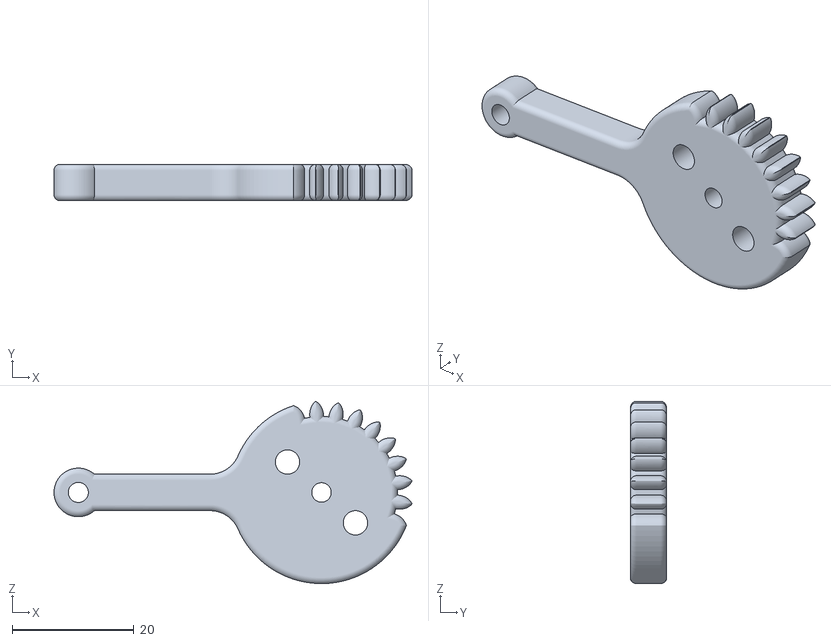
[picture p62: CAD file, 2018-02-10]
STL files/Machine - tool/Servo Gear.STL
58.9 x 6.00 x 30.0
