squaregolab/moveoperpi/STL files/Machine - tool/Cilinder.STL

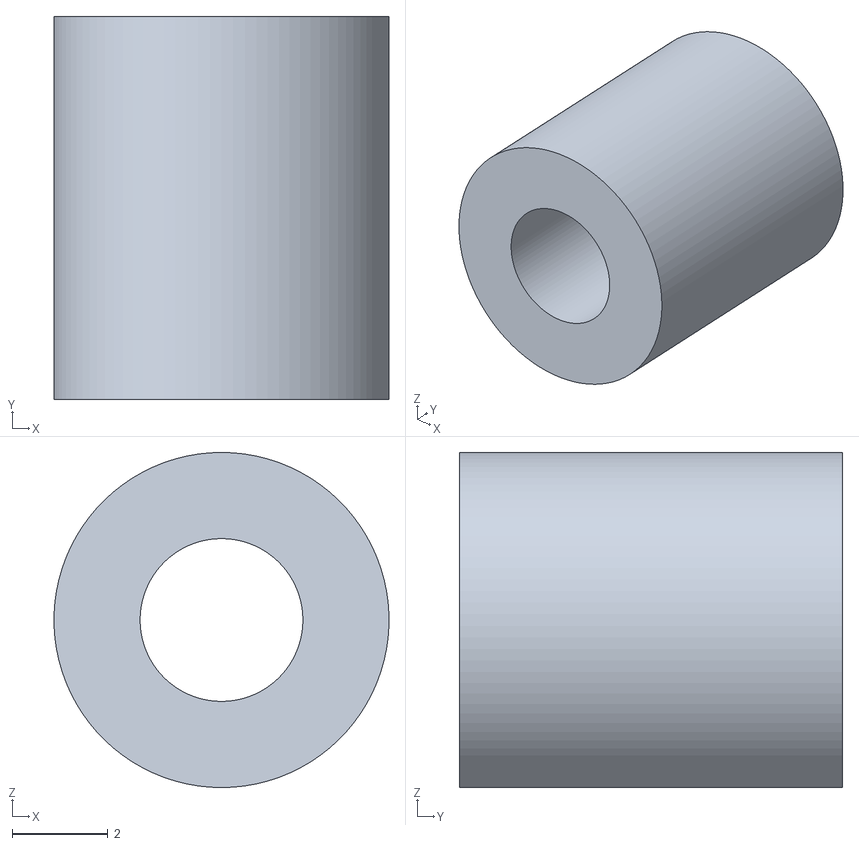
[picture p63: CAD file, 2018-02-10]
STL files/Machine - tool/Cilinder.STL
7.00 x 8.00 x 7.00
