squaregolab/moveoperpi/STL files/Machine - tool/Idol Gear.STL

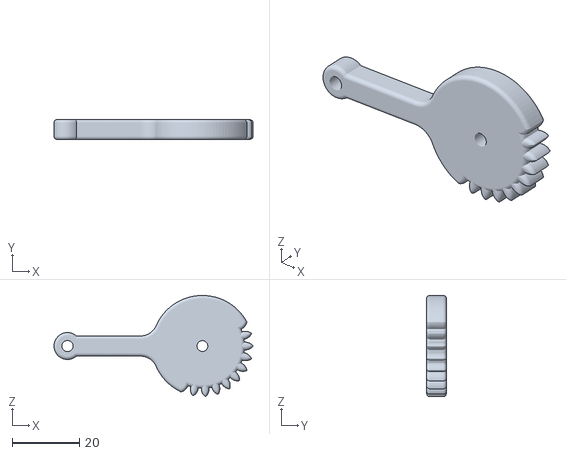
[picture p64: CAD file, 2018-02-10]
STL files/Machine - tool/Idol Gear.STL
59.0 x 6.00 x 30.0
