squaregolab/moveoperpi/CAD files/8mm Bearing.SLDPRT

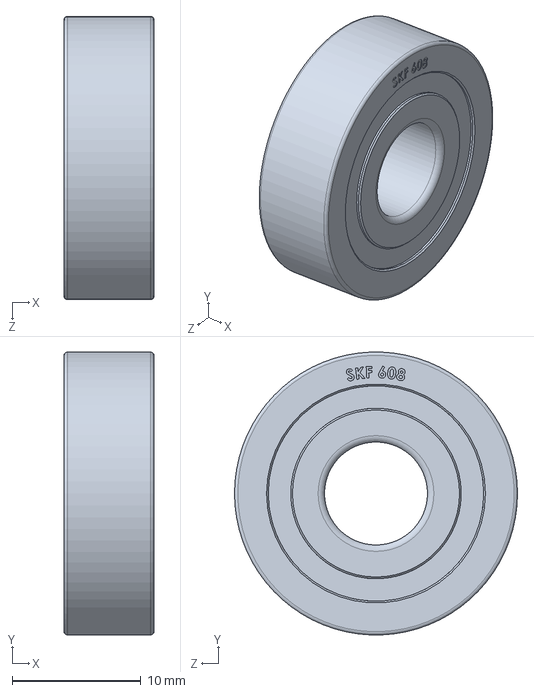
[picture p65: CAD file, 2018-02-10]
CAD files/8mm Bearing.SLDPRT
7.00 x 22.0 x 22.0 mm
