squaregolab/moveoperpi/CAD files/Fan.SLDPRT

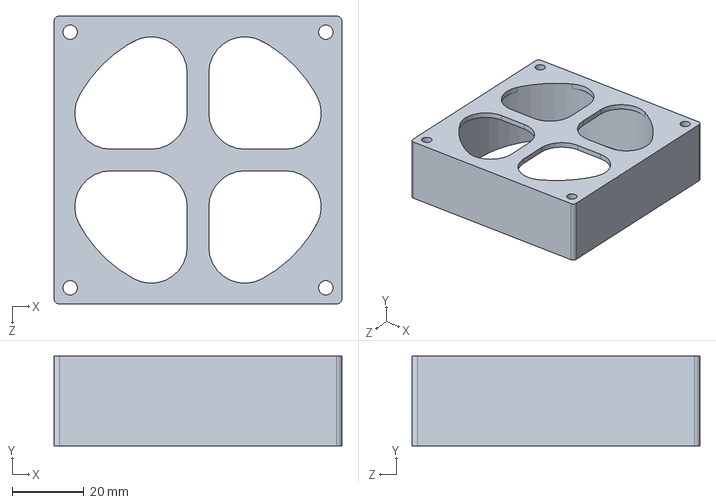
[picture p66: CAD file, 2018-02-10]
CAD files/Fan.SLDPRT
80.0 x 25.0 x 80.0 mm
