squaregolab/moveoperpi/CAD files/Nema 14.SLDPRT

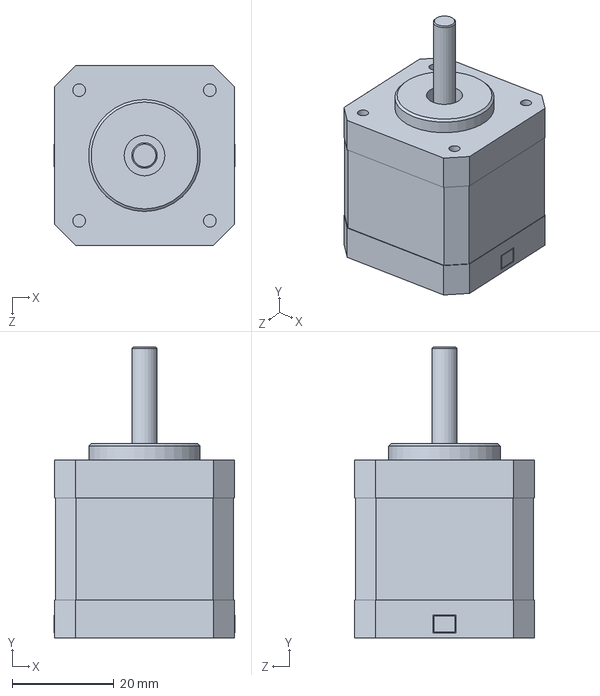
[picture p67: CAD file, 2018-02-10]
CAD files/Nema 14.SLDPRT
35.5 x 57.2 x 35.3 mm
