squaregolab/moveoperpi/CAD files/Bearing 4Bore 13Ext 5.SLDPRT

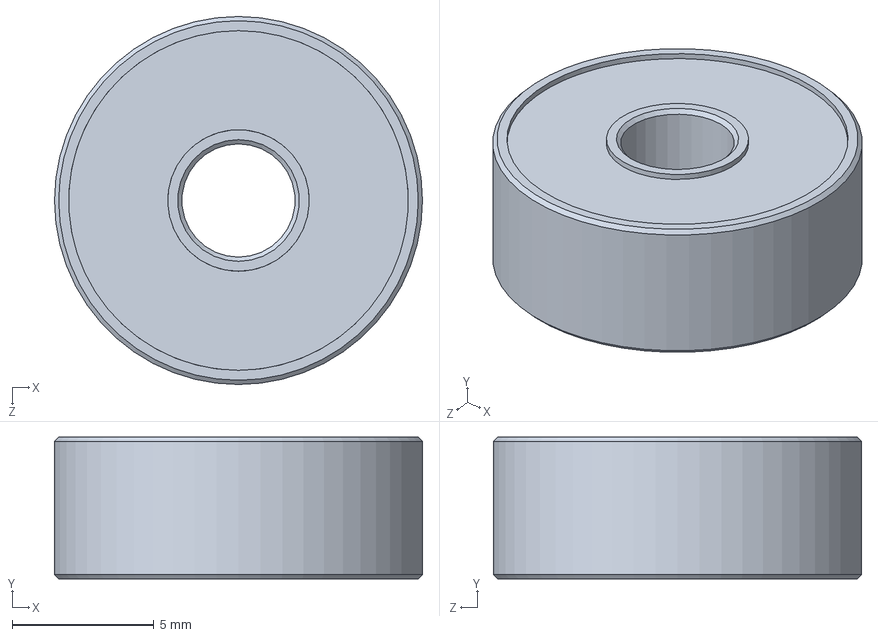
[picture p68: CAD file, 2018-02-10]
CAD files/Bearing 4Bore 13Ext 5.SLDPRT
13.0 x 5.00 x 13.0 mm
