squaregolab/moveoperpi/CAD files/4M2CB.SLDPRT

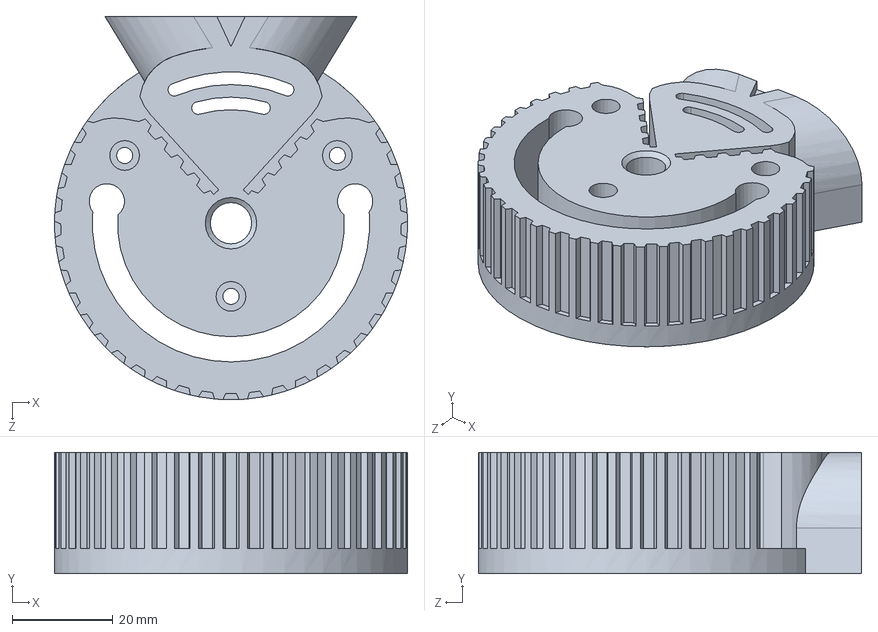
[picture p69: CAD file, 2018-02-10]
CAD files/4M2CB.SLDPRT
70.0 x 24.0 x 76.0 mm
