squaregolab/moveoperpi/CAD files/Nema 17 Reductor.SLDPRT

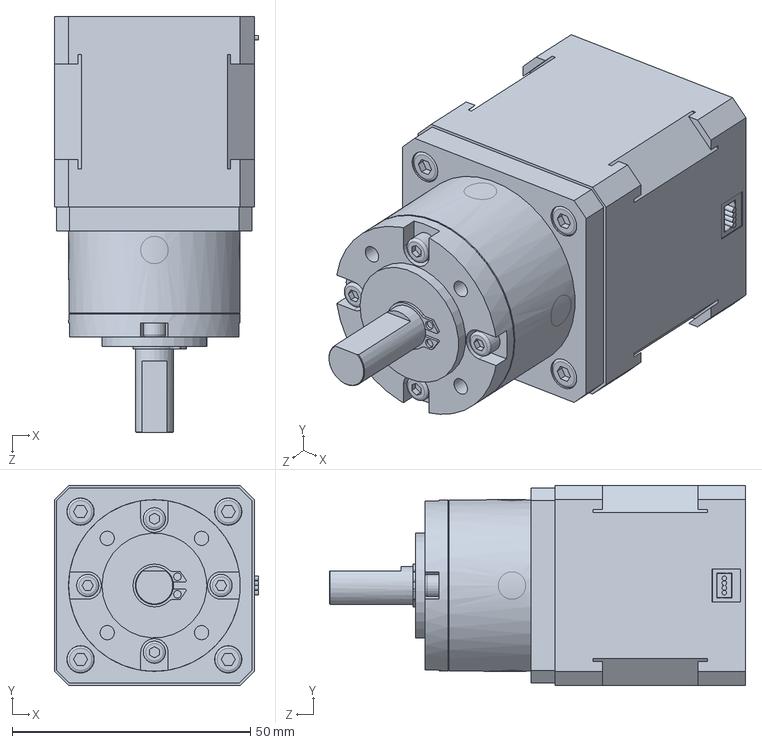
[picture p70: CAD file, 2018-02-10]
CAD files/Nema 17 Reductor.SLDPRT
42.9 x 42.0 x 87.3 mm
