squaregolab/moveoperpi/CAD files/Nema 17 Llarg.SLDPRT

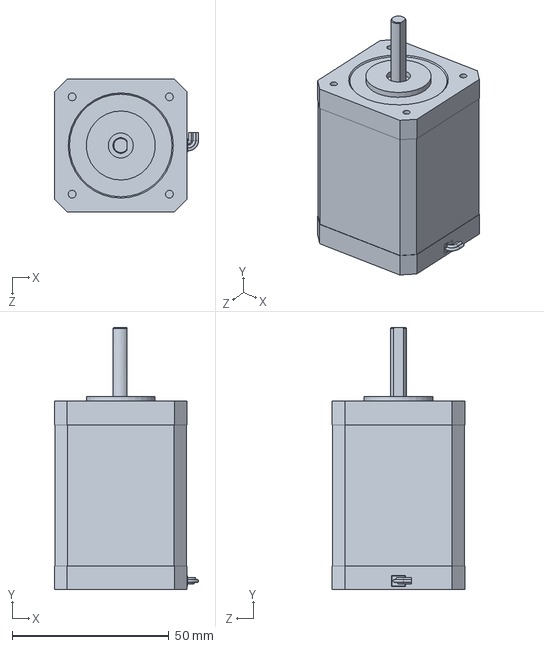
[picture p71: CAD file, 2018-02-10]
CAD files/Nema 17 Llarg.SLDPRT
46.0 x 83.5 x 42.3 mm
