squaregolab/moveoperpi/CAD files/Tapa 2M1C.SLDPRT

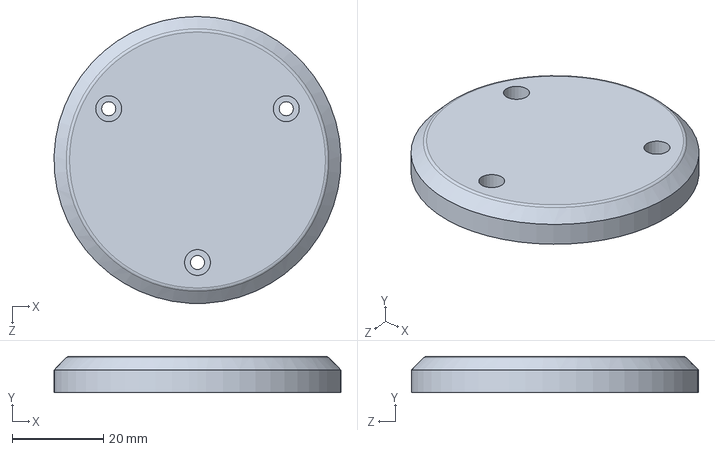
[picture p72: CAD file, 2018-02-10]
CAD files/Tapa 2M1C.SLDPRT
63.0 x 8.00 x 63.0 mm
