squaregolab/moveoperpi/CAD files/Capacitor 1.SLDPRT

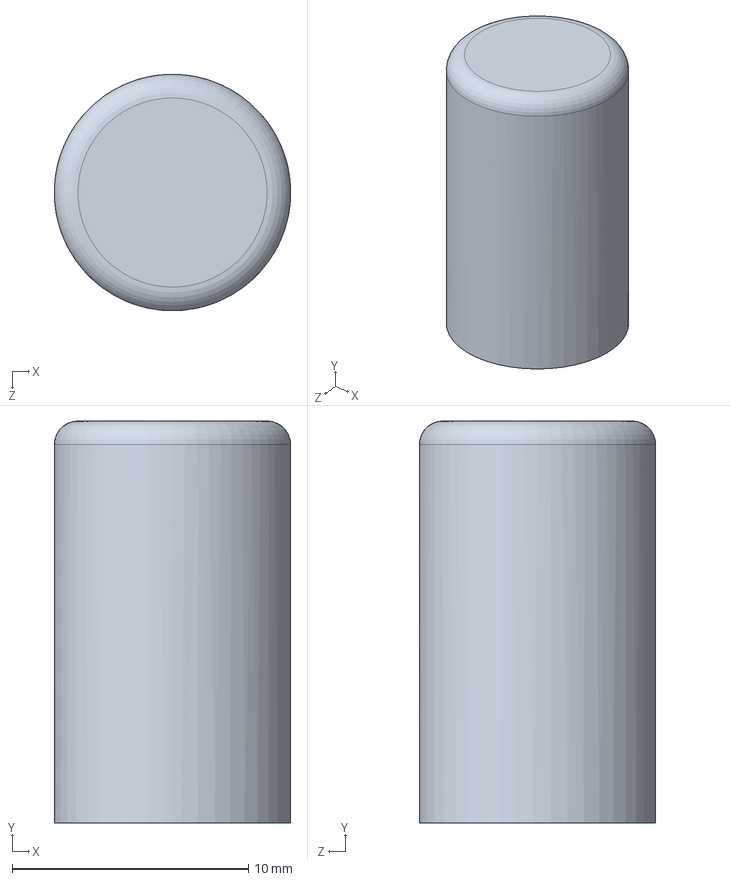
[picture p73: CAD file, 2018-02-10]
CAD files/Capacitor 1.SLDPRT
10.0 x 17.0 x 10.0 mm
