squaregolab/moveoperpi/CAD files/Box C.SLDPRT

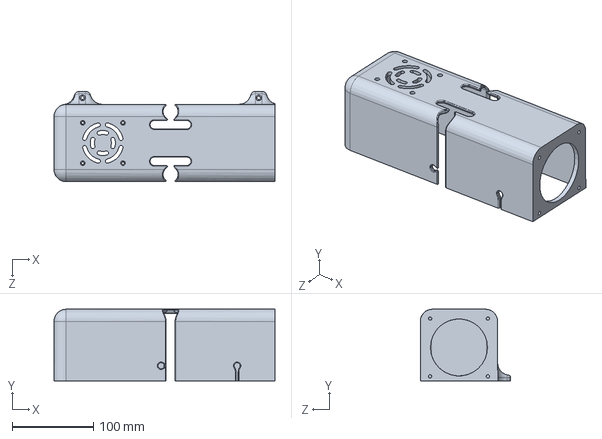
[picture p74: CAD file, 2018-02-10]
CAD files/Box C.SLDPRT
271.5 x 88.0 x 111.0 mm
