squaregolab/moveoperpi/CAD files/Nema 23.SLDPRT

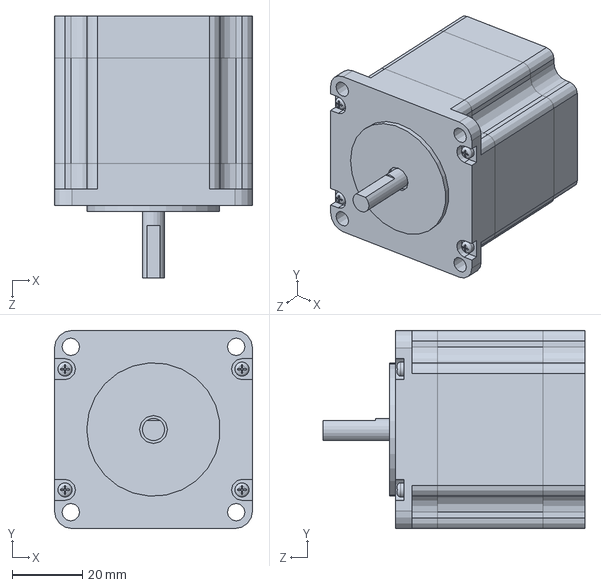
[picture p75: CAD file, 2018-02-10]
CAD files/Nema 23.SLDPRT
56.4 x 56.4 x 74.6 mm
