squaregolab/moveoperpi/CAD files/Capacitor 2.SLDPRT

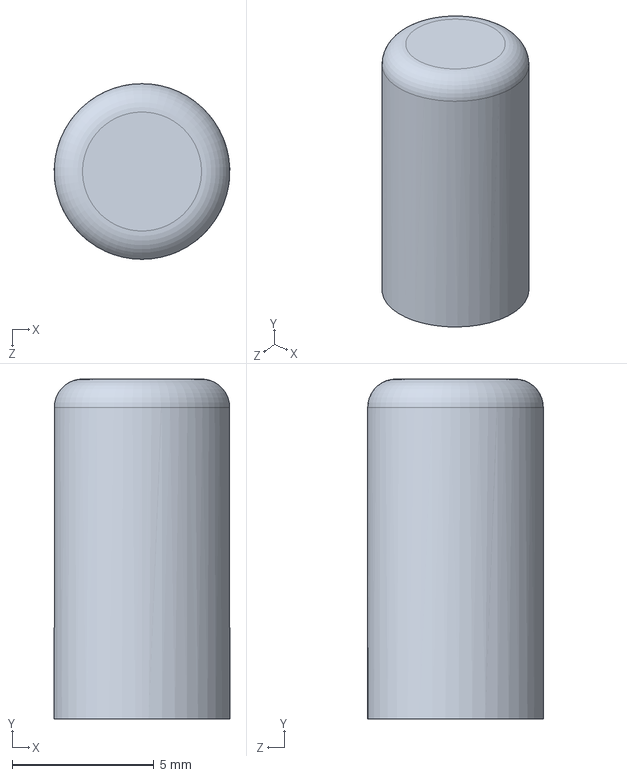
[picture p76: CAD file, 2018-02-10]
CAD files/Capacitor 2.SLDPRT
6.20 x 12.0 x 6.20 mm
