squaregolab/moveoperpi/CAD files/Nema 17 Curt.SLDPRT

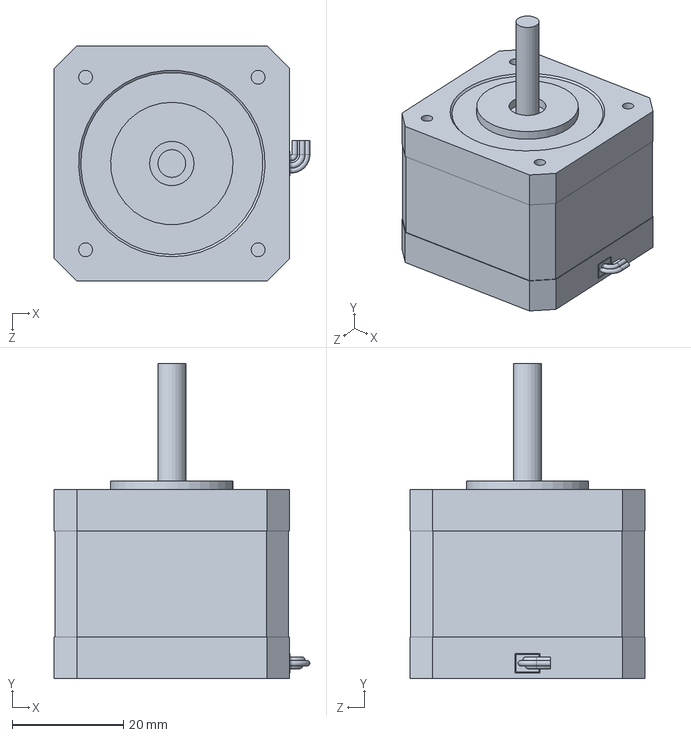
[picture p77: CAD file, 2018-02-10]
CAD files/Nema 17 Curt.SLDPRT
46.0 x 56.6 x 42.3 mm
