squaregolab/moveoperpi/CAD files/Spacer M8x20.SLDPRT

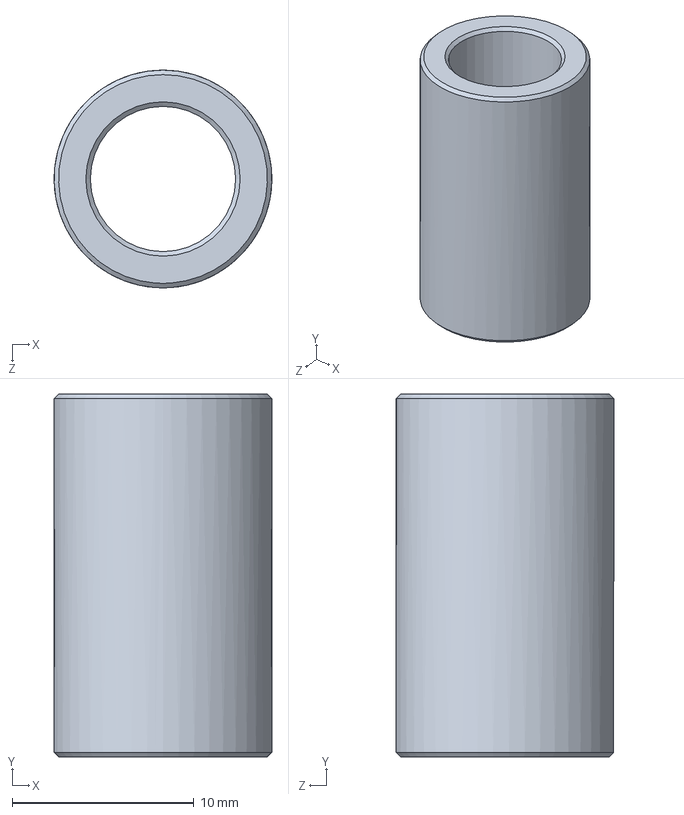
[picture p78: CAD file, 2018-02-10]
CAD files/Spacer M8x20.SLDPRT
12.0 x 20.0 x 12.0 mm
