squaregolab/moveoperpi/CAD files/PCB TB6560.SLDPRT

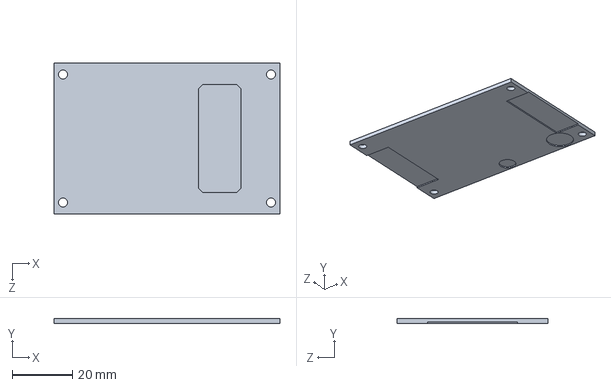
[picture p79: CAD file, 2018-02-10]
CAD files/PCB TB6560.SLDPRT
75.0 x 1.50 x 50.0 mm
