squaregolab/moveoperpi/CAD files/Volandera M3.SLDPRT

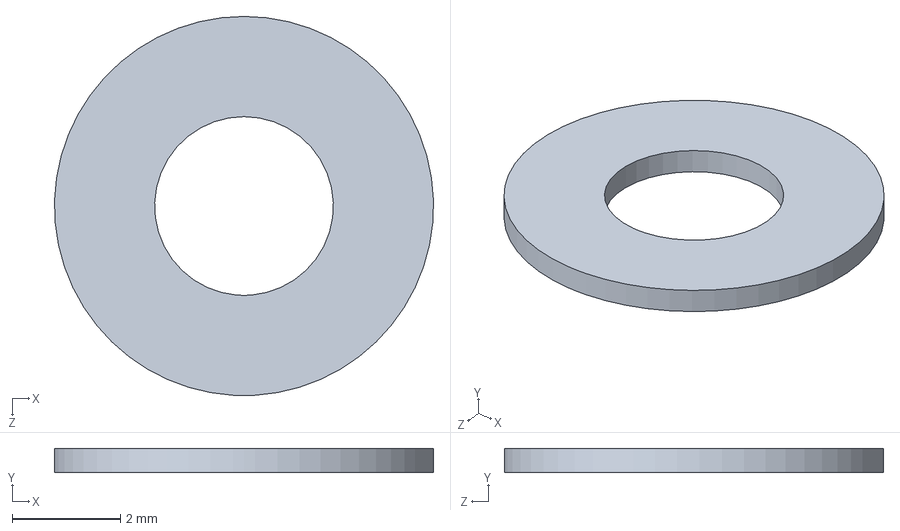
[picture p80: CAD file, 2018-02-10]
CAD files/Volandera M3.SLDPRT
7.00 x 0.45 x 7.00 mm
