squaregolab/moveoperpi/CAD files/Pulley 8mm IGNIS.SLDPRT

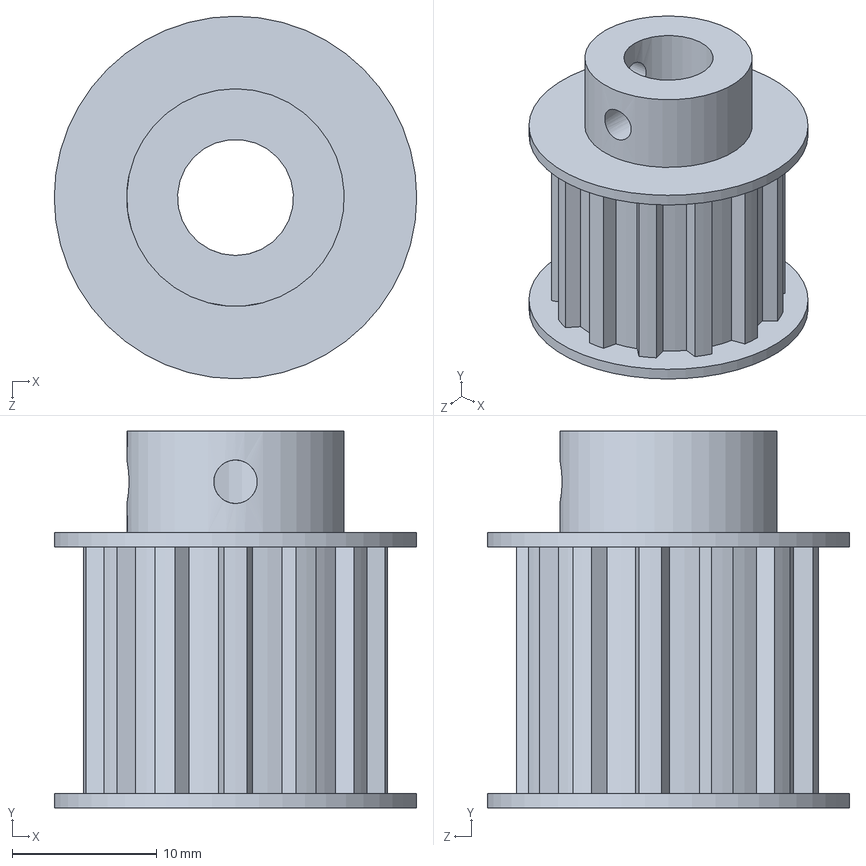
[picture p81: CAD file, 2018-02-10]
CAD files/Pulley 8mm IGNIS.SLDPRT
25.0 x 26.0 x 25.0 mm
