squaregolab/moveoperpi/CAD files/Terminal.SLDPRT

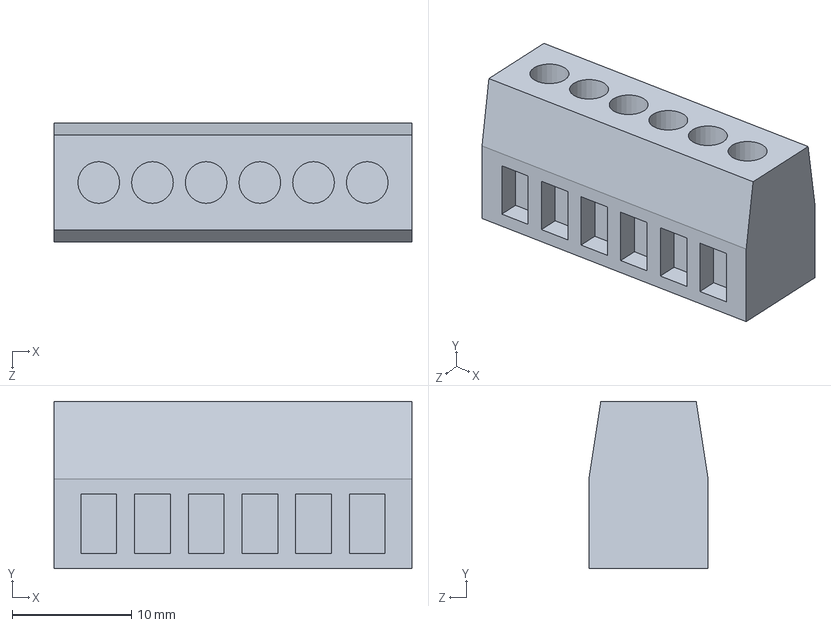
[picture p82: CAD file, 2018-02-10]
CAD files/Terminal.SLDPRT
30.0 x 14.0 x 10.0 mm
