squaregolab/moveoperpi/CAD files/Smooth bar 8mm x 50mm.SLDPRT

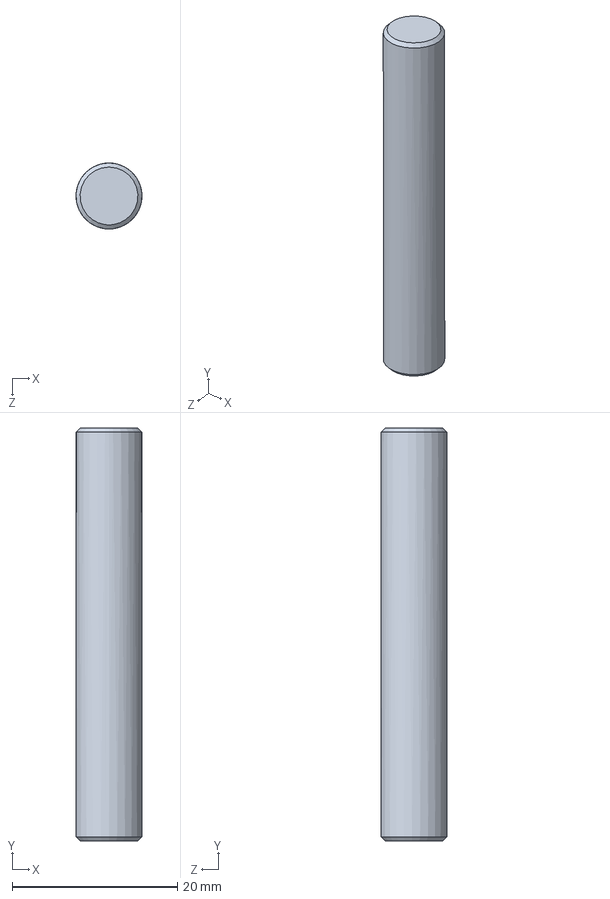
[picture p83: CAD file, 2018-02-10]
CAD files/Smooth bar 8mm x 50mm.SLDPRT
7.98 x 50.0 x 8.00 mm
