squaregolab/moveoperpi/CAD files/Brass insert M4.SLDPRT

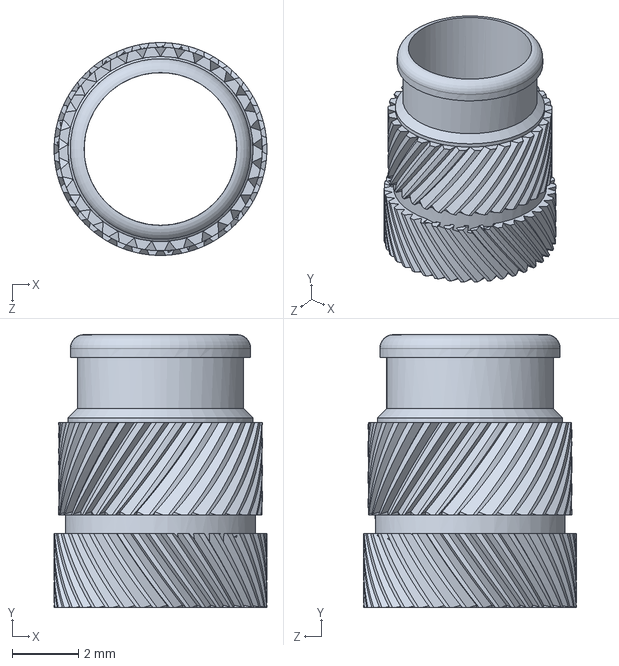
[picture p84: CAD file, 2018-02-10]
CAD files/Brass insert M4.SLDPRT
6.44 x 8.26 x 6.44 mm
