squaregolab/moveoperpi/CAD files/Bearing 3Bore 10Ext 4Height.SLDPRT

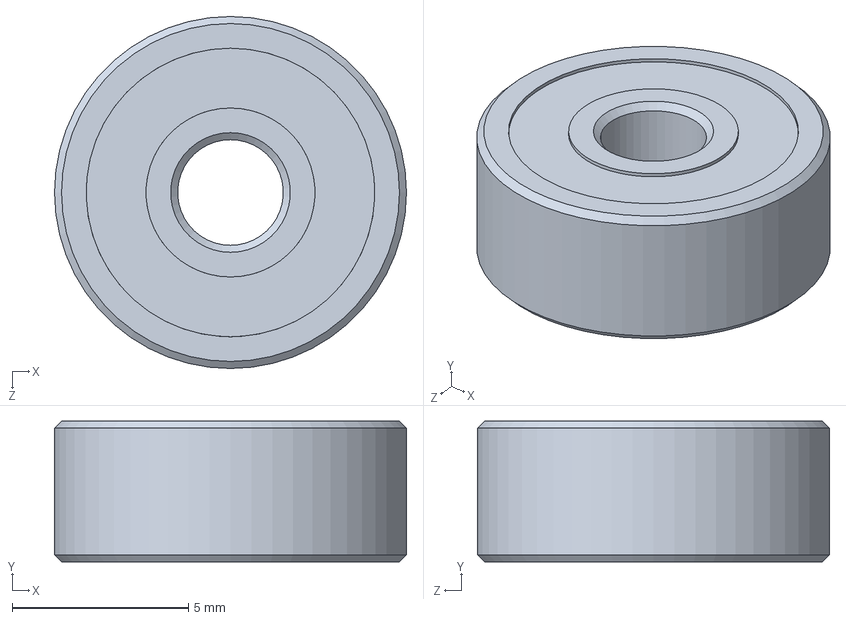
[picture p85: CAD file, 2018-02-10]
CAD files/Bearing 3Bore 10Ext 4Height.SLDPRT
10.0 x 4.00 x 10.0 mm
