squaregolab/moveoperpi/CAD files/Pulley M5.SLDPRT

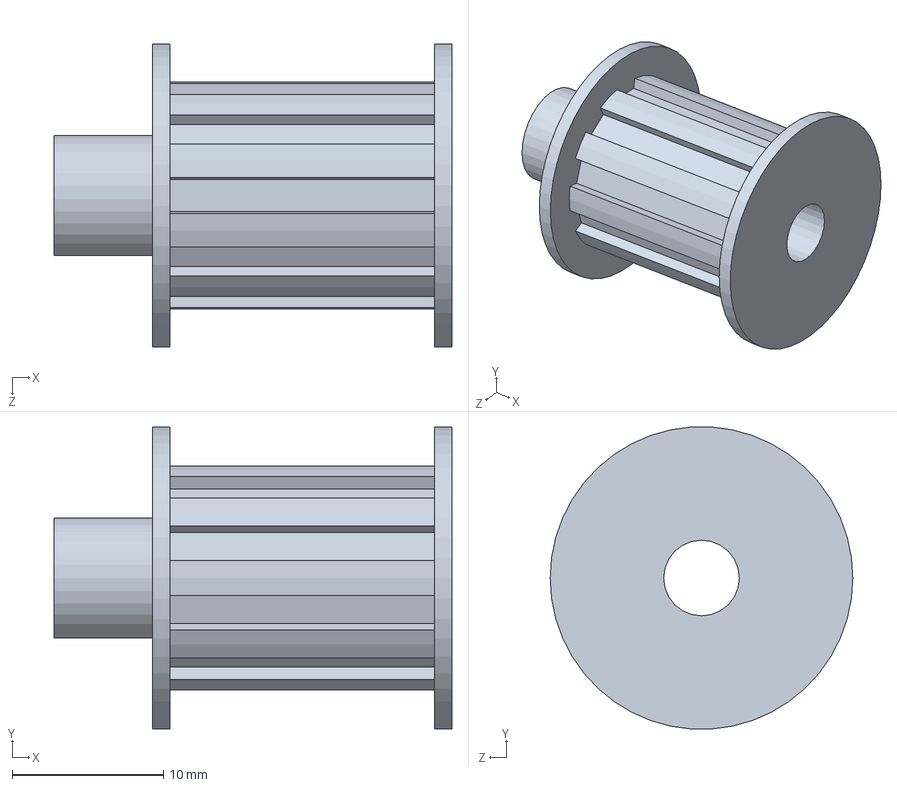
[picture p86: CAD file, 2018-02-10]
CAD files/Pulley M5.SLDPRT
26.3 x 20.0 x 20.0 mm
