squaregolab/moveoperpi/CAD files/Spacer M5x10.SLDPRT

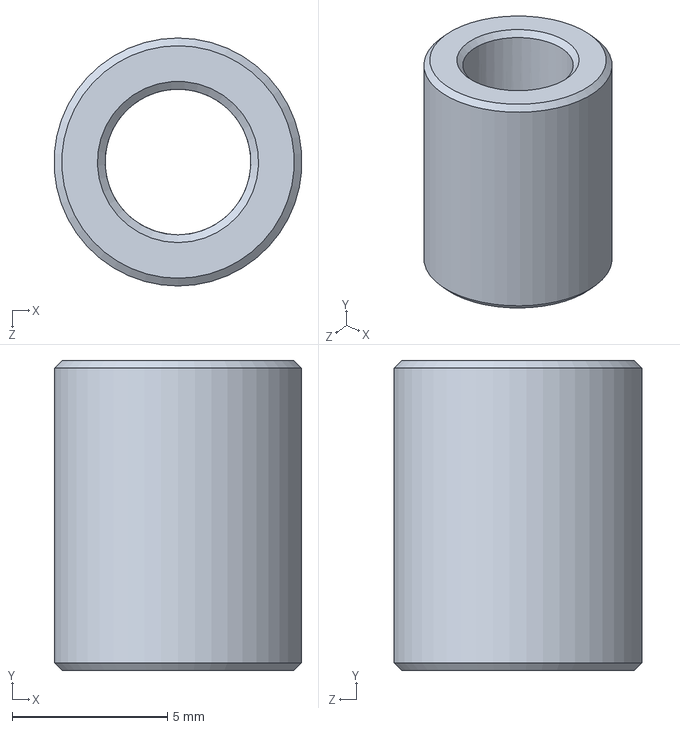
[picture p87: CAD file, 2018-02-10]
CAD files/Spacer M5x10.SLDPRT
7.98 x 10.0 x 8.00 mm
