squaregolab/moveoperpi/CAD files/M5 Lock.SLDPRT

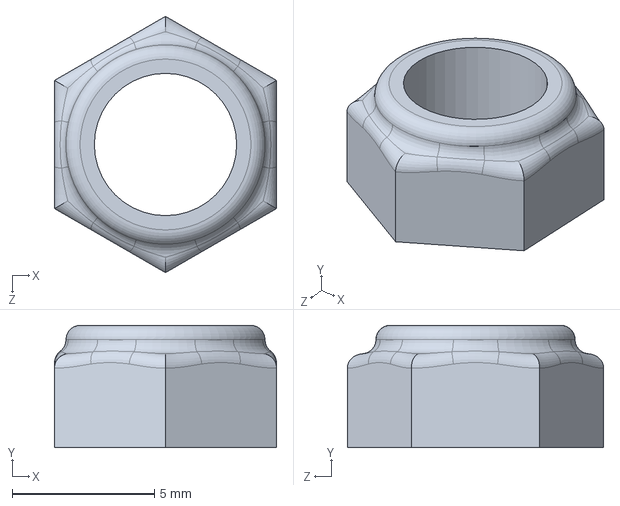
[picture p88: CAD file, 2018-02-10]
CAD files/M5 Lock.SLDPRT
7.80 x 4.30 x 9.01 mm
