squaregolab/moveoperpi/CAD files/Coupling 5 to 8 mm.SLDPRT

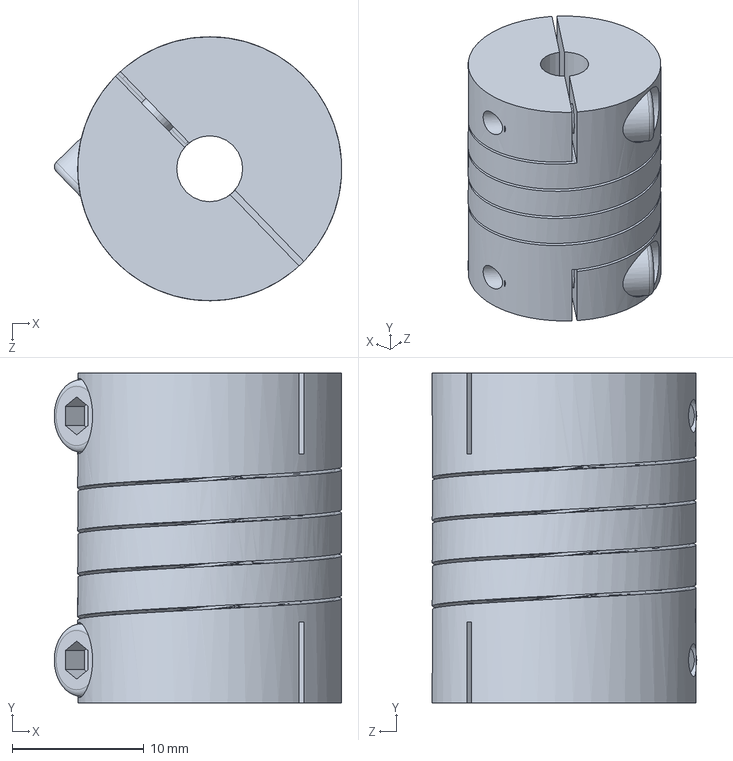
[picture p89: CAD file, 2018-02-10]
CAD files/Coupling 5 to 8 mm.SLDPRT
21.8 x 25.0 x 20.0 mm
