squaregolab/moveoperpi/CAD files/1M3A.SLDPRT

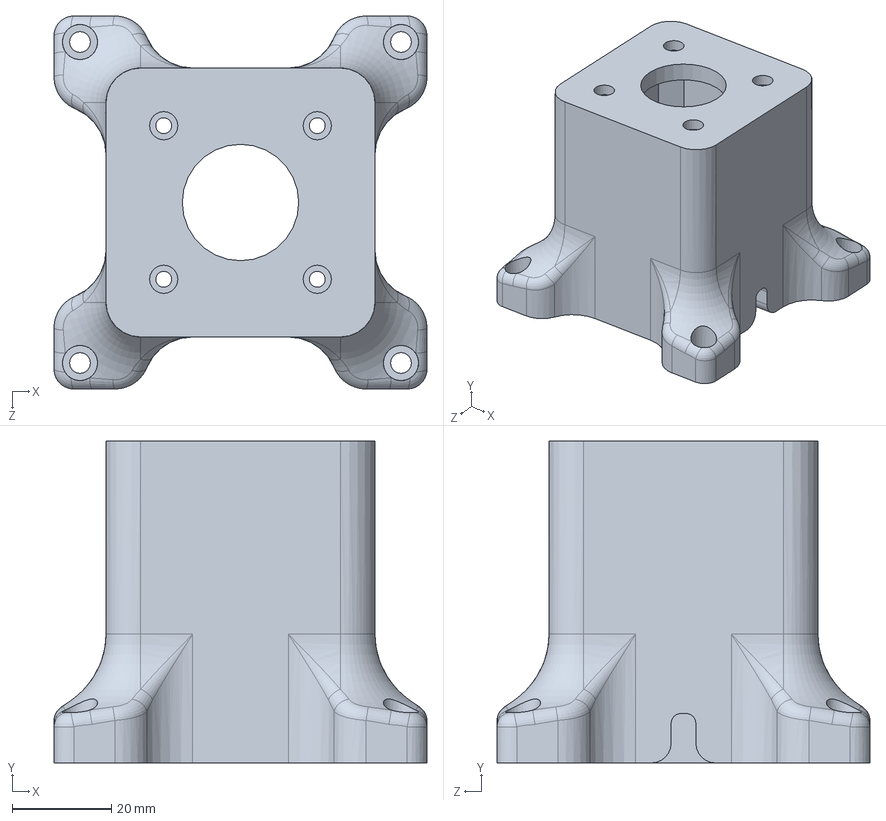
[picture p90: CAD file, 2018-02-10]
CAD files/1M3A.SLDPRT
75.3 x 65.0 x 75.3 mm
