squaregolab/moveoperpi/CAD files/Chip.SLDPRT

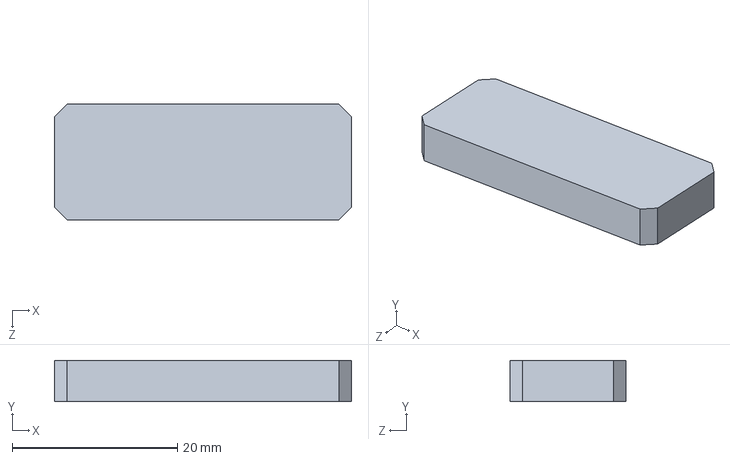
[picture p91: CAD file, 2018-02-10]
CAD files/Chip.SLDPRT
36.0 x 5.00 x 14.0 mm
