squaregolab/moveoperpi/CAD files/Sink.SLDPRT

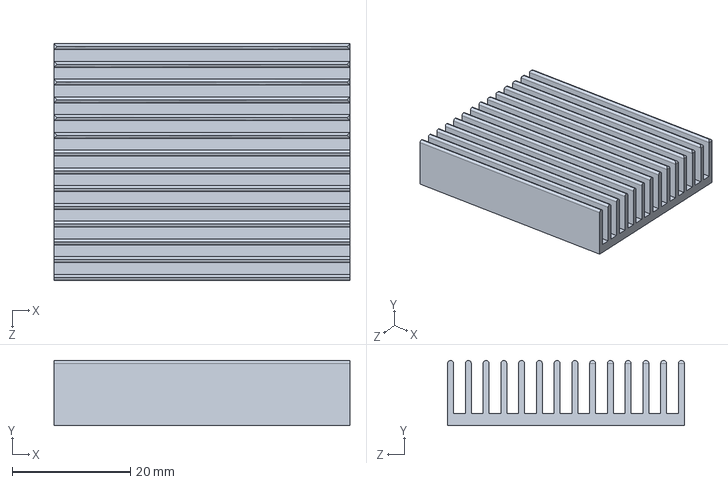
[picture p92: CAD file, 2018-02-10]
CAD files/Sink.SLDPRT
50.0 x 11.0 x 40.0 mm
