squaregolab/moveoperpi/CAD files/Base fusta.SLDPRT

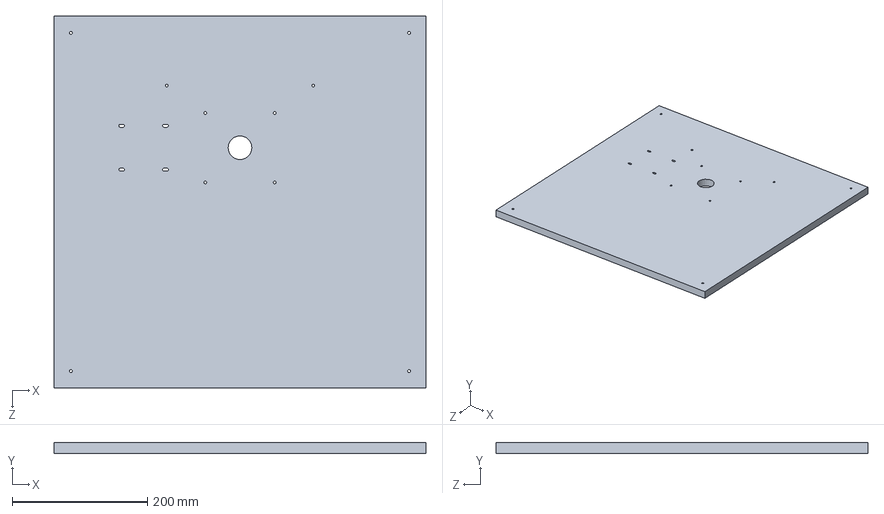
[picture p93: CAD file, 2018-02-10]
CAD files/Base fusta.SLDPRT
550.0 x 16.0 x 550.0 mm
