squaregolab/moveoperpi/CAD files/M8 Autoblocant.SLDPRT

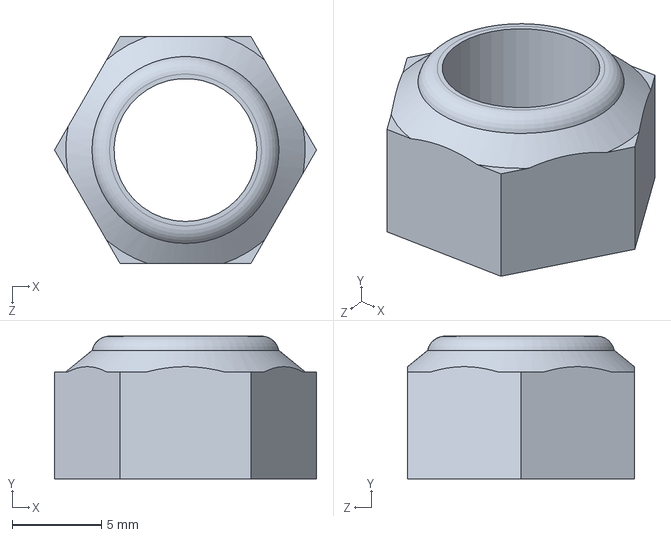
[picture p94: CAD file, 2018-02-10]
CAD files/M8 Autoblocant.SLDPRT
14.7 x 8.00 x 12.7 mm
