squaregolab/moveoperpi/CAD files/3M2CC.SLDPRT

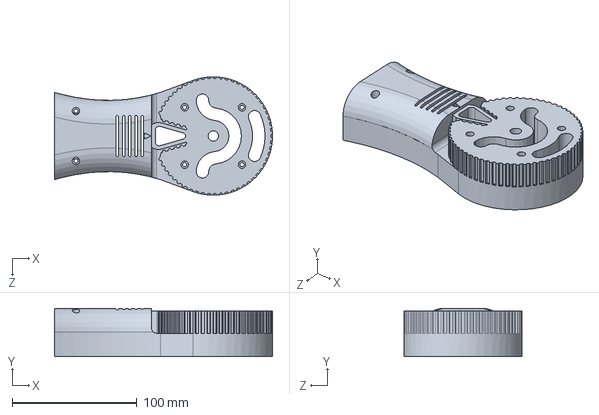
[picture p95: CAD file, 2018-02-10]
CAD files/3M2CC.SLDPRT
175.0 x 38.8 x 95.0 mm
