squaregolab/moveoperpi/CAD files/Smooth bar 8mm x 140mm.SLDPRT

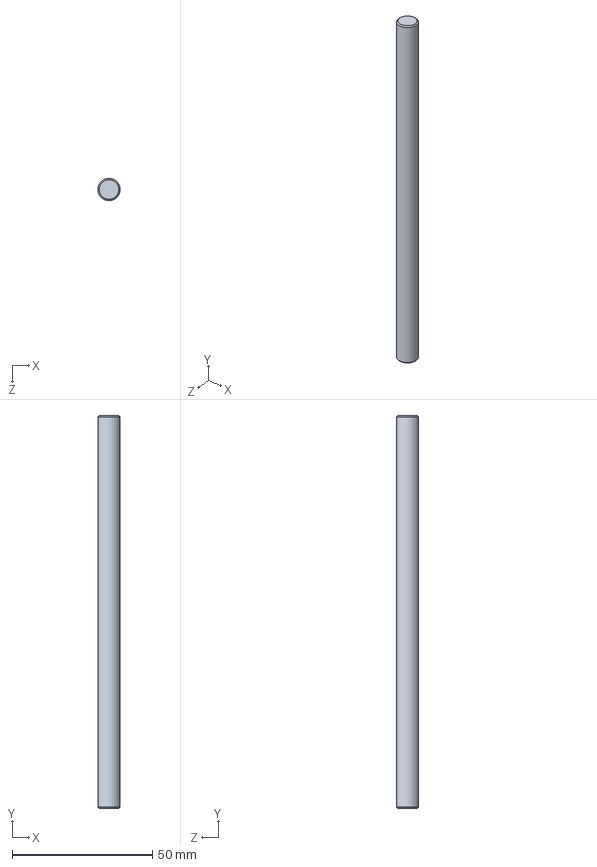
[picture p96: CAD file, 2018-02-10]
CAD files/Smooth bar 8mm x 140mm.SLDPRT
8.00 x 140.0 x 8.00 mm
