squaregolab/moveoperpi/CAD files/2M1D.SLDPRT

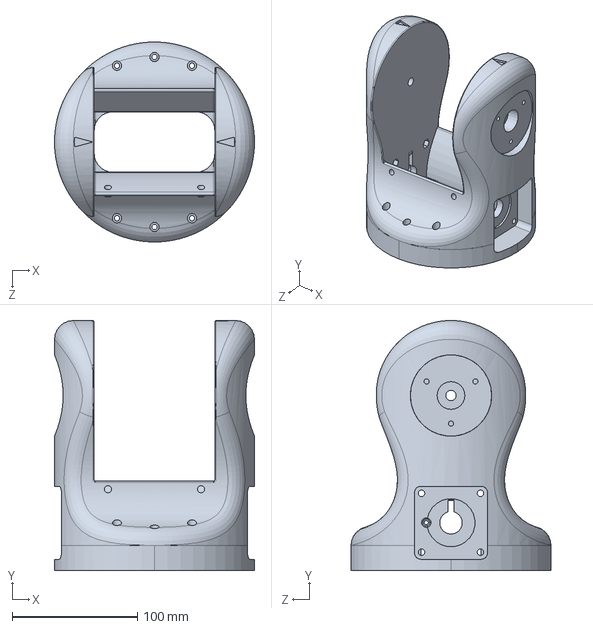
[picture p97: CAD file, 2018-02-10]
CAD files/2M1D.SLDPRT
160.0 x 200.0 x 160.0 mm
