squaregolab/moveoperpi/CAD files/Volandera M4.SLDPRT

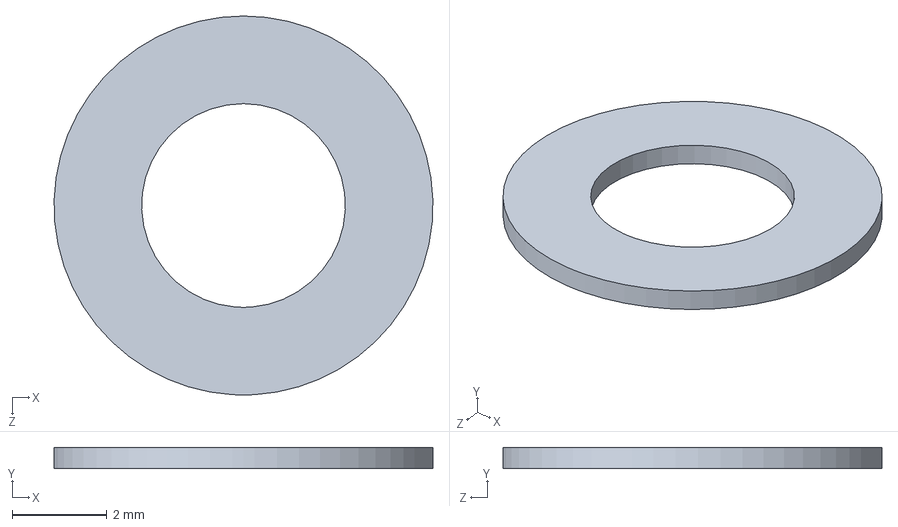
[picture p98: CAD file, 2018-02-10]
CAD files/Volandera M4.SLDPRT
8.00 x 0.45 x 8.00 mm
