squaregolab/moveoperpi/CAD files/M4 Locknut.SLDPRT

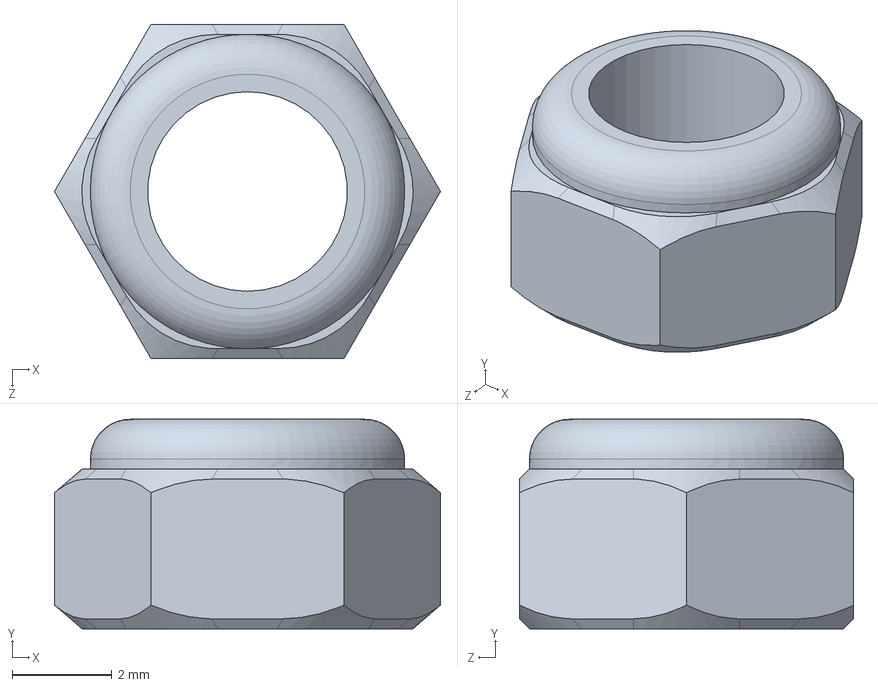
[picture p99: CAD file, 2018-02-10]
CAD files/M4 Locknut.SLDPRT
7.74 x 4.20 x 6.70 mm
