squaregolab/moveoperpi/CAD files/3M2C.SLDPRT

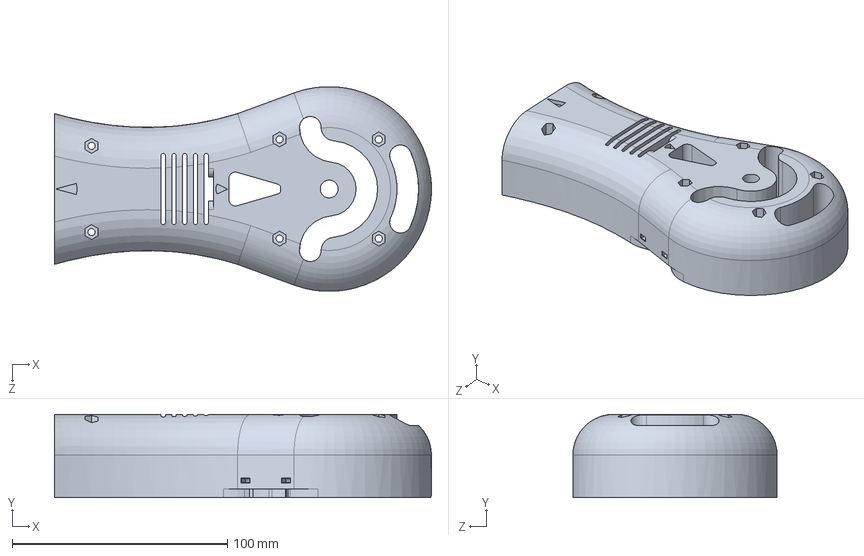
[picture p100: CAD file, 2018-02-10]
CAD files/3M2C.SLDPRT
175.0 x 38.8 x 94.9 mm
