squaregolab/moveoperpi/CAD files/Bottom Plate C.SLDPRT

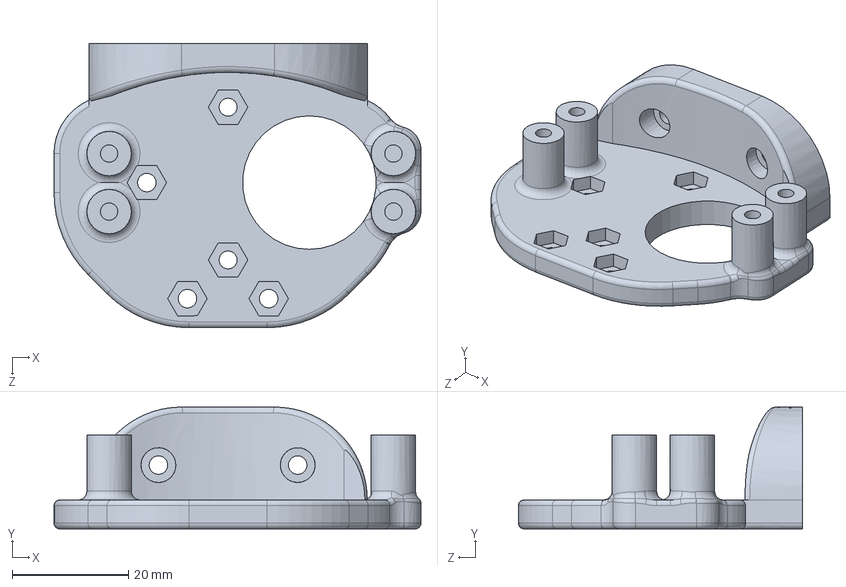
[picture p101: CAD file, 2018-02-10]
CAD files/Bottom Plate C.SLDPRT
63.2 x 21.0 x 49.0 mm
