squaregolab/moveoperpi/CAD files/Barra llisa 8mm x 80mm.SLDPRT

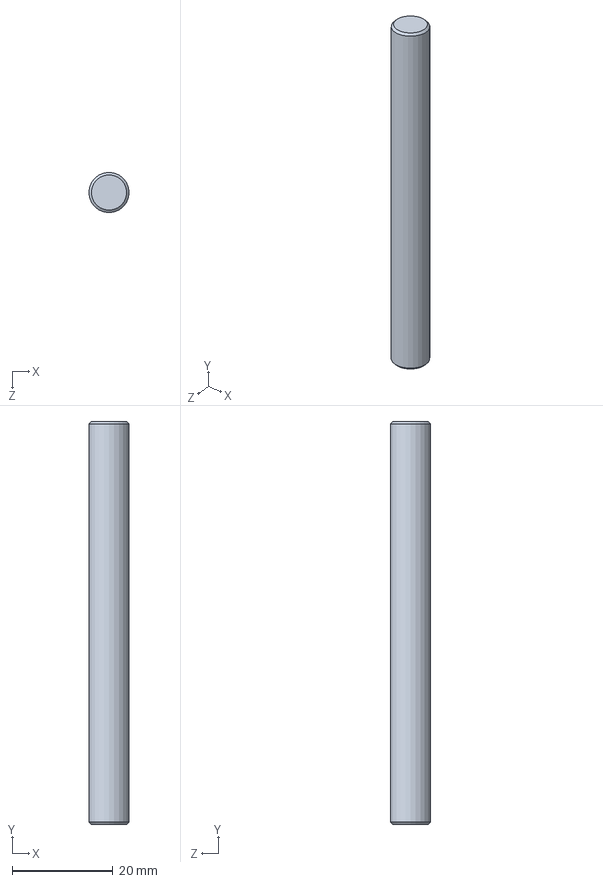
[picture p102: CAD file, 2018-02-10]
CAD files/Barra llisa 8mm x 80mm.SLDPRT
8.00 x 80.0 x 8.00 mm
