squaregolab/moveoperpi/CAD files/Brass insert M3.SLDPRT

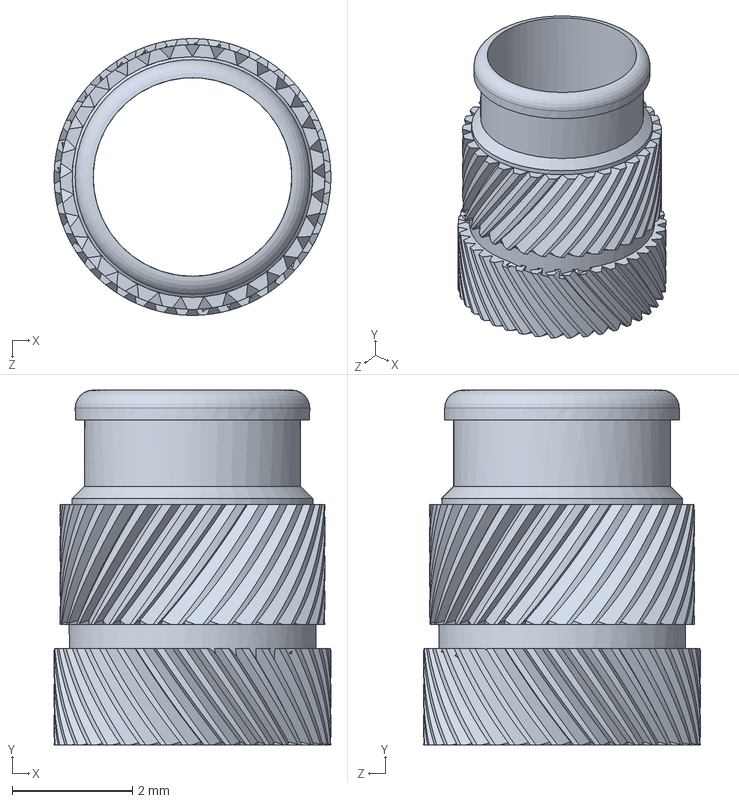
[picture p103: CAD file, 2018-02-10]
CAD files/Brass insert M3.SLDPRT
4.60 x 5.90 x 4.60 mm
