squaregolab/moveoperpi/CAD files/Volandera M5.SLDPRT

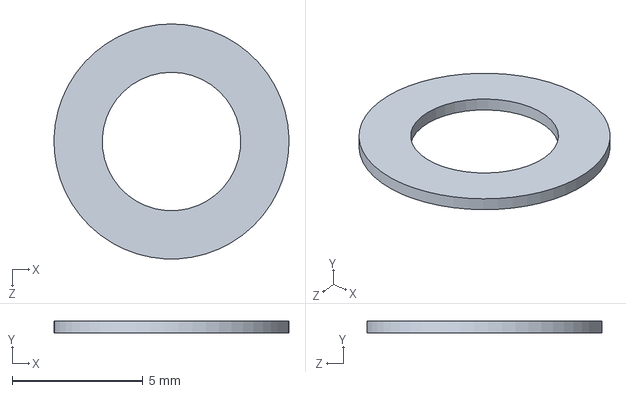
[picture p104: CAD file, 2018-02-10]
CAD files/Volandera M5.SLDPRT
9.00 x 0.45 x 9.00 mm
