squaregolab/moveoperpi/(list of files, cad)

Other CAD files:
CAD files/2M2 assembly.SLDASM
STL files/Articulation 1/1M2.STL
STL files/Articulation 2/2M2H.STL
STL files/Machine - tool/Gripper Right.STL
CAD files/4M2B.SLDPRT
CAD files/Top Plate C.SLDPRT
CAD files/Idol Gear B.SLDPRT
CAD files/Pivot Arm B.SLDPRT
CAD files/T2M1BD.SLDPRT
CAD files/TBC.SLDPRT
CAD files/Tapa 3M1C.SLDPRT
CAD files/Gripper Right B.SLDPRT
CAD files/Gripper Left B.SLDPRT
CAD files/Fan Module.SLDPRT
CAD files/2M2MA.SLDPRT
CAD files/Suport Drivers E.SLDPRT
CAD files/Servo Gear B.SLDPRT
CAD files/2M2HA.SLDPRT
CAD files/Cilinder.SLDPRT
CAD files/T3M1C.SLDPRT
CAD files/Tapa 4M1D.SLDPRT
CAD files/T4M1E.SLDPRT
CAD files/Potes base B.SLDPRT
CAD files/T2M1BI.SLDPRT
CAD files/M3 Nut.SLDPRT
CAD files/M3x10.SLDPRT
CAD files/M3x12.SLDPRT
CAD files/M3x16.SLDPRT
CAD files/M3x20.SLDPRT
CAD files/M3x25.SLDPRT
CAD files/M3x35.SLDPRT
CAD files/M3x40.SLDPRT
CAD files/M3x8.SLDPRT
CAD files/M4 Nut.SLDPRT
CAD files/M4x16.SLDPRT
CAD files/M4x20.SLDPRT
CAD files/M4x30.SLDPRT
CAD files/M4x40.SLDPRT
CAD files/M4x45.SLDPRT
CAD files/M5x15.SLDPRT
CAD files/M5x20.SLDPRT
CAD files/M5x30.SLDPRT
CAD files/M8x65.SLDPRT
